326hhh/HLJU_RMIC_chassis/docs/README.md

# 底盘工程文档（底盘库 + 通信链路 + IMU + 上位机对接）

> 本文由原 `docs/CHASSIS_LIBRARY.md`、`docs/CAN_TEST.md`、`docs/CAN_CONTROL_PROTOCOL.md`
> 合并精简而成（2026-11-05），**章节编号沿用原 `CHASSIS_LIBRARY.md` 的 1~19**，
> 因此代码与 `UserLib/*/README.md` 里「见 docs/…§10 / §17 / §6.6」这类引用依旧有效
> （例外：§17 内部合并掉了两节、小节号顺延——原 §17.6 验证现状 → **§17.5**、
> 原 §17.8 一卡一卡 → **§17.7**、原 §17.9 A/B 诊断 → **§17.8**，相关引用已同步改过来）。
> 合并方式是「留结论、删过程」：协议字段表、参数表、标定/实测数据、排障判定表全部保留，
> 长篇排查流水账压成一两行结论。
>
> 分工：**接线**以项目根目录 `README.md` 为准（本文只引用不重复）；
> **各模块用法速查**在 `UserLib/Chassis/README.md` / `UserLib/Comm/README.md` / `UserLib/IMU/README.md`。

- 适用平台：STM32F407VGTx + TB6612 ×2 + 亚博智能 L 型 520 编码器减速电机 ×4（麦克纳姆轮底盘）
- 电机参数：减速比 1:40，磁环 11 线，12 V 供电，减速后空载约 300 RPM（±5%）
- 控制方式：四轮速度闭环（速度前馈 + 参考加速度前馈 + PI）+ 里程计，裸机 1 kHz 周期调度
- 整定状态：2026-10-18 完成四轮速度环实机整定（架空、满占空比），参数见 §7、指标见 §11.3
- IMU：2026-10-19 打通定型（硬件 I2C 400 kHz、SA0 直连 GND、20 分钟 soak 零错误），见 §17
- 上位机：Jetson Nano `~/gimbal`（C++17，控制云台 ZDT X42S ×2）+ 笔记本 `~/gimbal_ctl`，见 §16
- 通信：USART2 串口链路 `uart_link`（§18）与 CAN1 链路 `can_link`（§15），两条链路协议逐字段一致

---

## 目录

| 章 | 内容 |
|---|---|
| [§1](#1-概述) | 概述与设计目标 |
| [§2](#2-参考与借鉴) | 参考与借鉴 |
| [§3](#3-目录结构) | 目录结构 |
| [§4](#4-坐标系与符号约定rm-约定) | 坐标系与符号约定 |
| [§5](#5-架构与数据流) | 架构与数据流（1 kHz 单拍链路） |
| [§6](#6-模块说明) | 模块说明（motor / encoder / pid / mecanum / chassis / debug / demo / tune） |
| [§7](#7-参数配置chassis_configh) | 参数配置与速度环增益 |
| [§8](#8-硬件绑定表chassisc-中-s_bind) | 硬件绑定表 |
| [§9](#9-集成方式) | 集成方式（main.c / NVIC / 编译开关） |
| [§10](#10-上电校准务必按顺序做) | 上电校准（CPR / 方向 / 运动学符号 / 死区） |
| [§11](#11-pid-整定) | PID 整定 |
| [§12](#12-演示程序说明) | 演示程序 |
| [§13](#13-已知限制与后续计划) | 已知限制与后续计划 |
| [§14](#14-附录-a运动学公式推导) | 附录 A：运动学公式推导 |
| [§15](#15-can-通信can_test-验证--can_link-正式协议) | **CAN 通信**：位时序 / `can_test` 验证 / `can_link` 正式协议 / 联调实测 / 排障复盘 |
| [§16](#16-上位机工程jetson-gimbal) | 上位机工程 Jetson `~/gimbal` 与对接点 |
| [§17](#17-imulsm6dsv16x与陀螺偏航闭环小陀螺) | IMU（LSM6DSV16X）与陀螺偏航闭环（小陀螺） |
| [§18](#18-usart2-上位机控制链路userlibcommuart_link) | USART2 控制链路 `uart_link` |
| [§19](#19-版本记录) | 版本记录 |

---

## 1. 概述

本库把底盘控制拆成「测量 / 控制 / 运动学」三层，目标是与 RM（RoboMaster）开源工程同等的工程化水平：

- **测量层**：TIM 编码器模式采样（输入带数字滤波），16 位计数器溢出拼接为 32 位累计，滑动窗口测速；
- **控制层**：车体速度指令 → 麦克纳姆逆解 → 每轮斜坡限幅 → 速度环（速度前馈 + 参考加速度前馈 + PI）→ TB6612 占空比；
- **运动学层**：逆解（指令分配）与正解（里程计）互为逆运算，符号统一。

## 2. 参考与借鉴

结构设计参考了 RM 开源底盘代码的成熟模式（measure/control 分离、轮速斜坡、速度环 PID、运动学独立模块）：

- RoboMaster 开发板 C 型示例工程：<https://github.com/RoboMaster/Development-Board-C-Example>
- rm-controls 框架：<https://github.com/rm-controls/rm_control>

本库为独立实现：不依赖 RTOS、不依赖裁判系统，坐标符号与 RM 约定保持一致，便于后续对接 RM 生态代码。

## 3. 目录结构

```
UserLib/Chassis/
├── chassis_config.h    # 全部可调参数（物理参数/限幅/PID/方向），唯一需要常改的文件
├── chassis_math.h      # 限幅、角度归一、斜坡等内联工具
├── motor.h/.c          # TB6612 单路电机抽象（占空比 ±1000）
├── encoder.h/.c        # 编码器抽象（输入滤波 + 累计计数 + 窗口测速）
├── pid.h/.c            # 位置式 PI(D)：速度前馈、条件积分抗饱和、微分低通
├── mecanum.h/.c        # 麦克纳姆运动学正解/逆解
├── chassis.h/.c        # 主模块：硬件绑定、1 kHz 控制循环、里程计
├── chassis_gyro.h/.c   # 陀螺偏航闭环：小陀螺自旋 / 云台跟随（见 §17）
├── chassis_demo.h/.c   # 演示状态机（可整文件删除）
├── chassis_debug.h/.c  # USART1 调试打印（可用 CHASSIS_DEBUG_ENABLE 关闭）
└── chassis_tune.h/.c   # PID 整定实验模块（默认关闭，见 §6.8）
UserLib/Comm/
├── README.md           # 通信层速查（uart_link / can_link / can_test）
├── uart_link.h/.c      # USART2 串口链路（§18），并对外提供 4 个复用入口供 CAN 调用
├── uart_link_codec.h   # 12 B / 40 B 帧编解码纯函数（PC 侧可编译）
├── uart_link_config.h  # 串口链路全部常量（帧长/命令字/status 位/超时）
├── can_link.h/.c       # CAN1 正式链路（§15.9），协议零重写，只做搬运
├── can_link_config.h   # CAN 帧 ID、位时序、队列深度、错误阈值、CAN_LINK_ENABLE
├── can_test.h/.c       # CAN 链路验证/排障工具（§15.3~§15.6）
└── can_test_config.h   # can_test 全部可调参数 + CANTEST_ENABLE
UserLib/IMU/
├── README.md           # 驱动本身怎么用（接口速查/配置表/上电时序/坑）
├── imu_config.h        # IMU 配置表（I2C 地址/量程/采样率/轴映射）
├── imu.h/.c            # LSM6DSV16X 驱动：I2C 层 + 零偏标定 + 采样 + yaw 积分
├── lsm6dsv16x_reg.h/.c # ST 官方驱动（原样拷贝，不要手改）
tools/
├── step_analysis.py    # 整定数据解析：SET/STEP 二进制块 → 指标 + 曲线
├── spin_analysis.py    # 陀螺自旋实验（实验 5）解析：稳态误差/纹波/超调/漂移
├── uart_link_test.py    # 协议测试向量 + 独立 Python 交叉校验
└── codec_test.c        # PC 上用 gcc 编译 uart_link_codec.h 做编解码自检
test_data/
├── tune_runs/          # 2026-10-18 整定实测原始抓取（.log）与中间结果
└── spin_runs/          # 陀螺噪声/手转/自旋实验的原始串口抓取
docs/
└── README.md           # 本文（原 CHASSIS_LIBRARY.md / CAN_TEST.md / CAN_CONTROL_PROTOCOL.md 已合并至此）
```

## 4. 坐标系与符号约定（RM 约定）

```
            +x（车体前进方向）
             ^
             |
      FL(0)  |  FR(1)         轮子编号顺序：
             |                 0 = FL 左前, 1 = FR 右前
   +y <------+------->         2 = BL 左后, 3 = BR 右后
  （车体左侧）
             |
      BL(2)  |  BR(3)
```

| 量 | 约定 |
|---|---|
| `vx` | +x = 车体前进（m/s） |
| `vy` | +y = 车体左移（m/s） |
| `wz` | 俯视**逆时针**为正（rad/s） |
| 轮速 | 正 = 该轮沿 +x 向前滚动（RPM） |
| 里程计 yaw | 与 wz 同符号，逆时针为正，初始为 0 |

> 这条约定同时是 **USART2 链路（§18.2）**、**CAN 链路（§15.7）** 与 **上位机 `ChassisCommand`（§16.7）**
> 的坐标口径，三条链路已统一，上位机发帧前不需要任何轴交换或取反。
> 旧草案里「`vx` 右 / `vy` 前」的说法已废弃。

## 5. 架构与数据流

```
chassis_set_velocity(vx, vy, wz)
        │
        ▼
┌──────────────────────┐   ┌──────────────────────┐
│  mecanum_inverse()   │   │   encoder_update()   │
│  车体速度 → 四轮RPM  │   │  16bit→32bit + 窗口测速 │
└──────────┬───────────┘   └──────────┬───────────┘
           │ 轮速限幅 ±250RPM         │ 方向归一(ENC_DIR)
           │ 斜坡 ±1500RPM/s          ▼
           ▼                   wheel_rpm_meas[4]
      wheel_rpm_ref[4]                │
           │                          │
           ▼                          ▼
      pid_calc()            mecanum_forward()
      duty = Kff·ref        实测轮速 → vx/vy/wz
           + Kacc·dref/dt          │
           + Kp·e + Ki·∫e           ▼
           （条件积分抗饱和）    里程计积分 (x, y, yaw)
           │
           ▼
      motor_set_duty()
      （±1000 → TB6612 IN1/IN2 + PWM CCR）
```

整条链以 1 kHz 执行一次：`chassis_poll()` 内部检测 `HAL_GetTick()` 的 1 ms 节拍，到点跑一拍。
**主循环里不能再用 `HAL_Delay()` 长时间阻塞**，否则控制会掉拍（掉拍的后果见 §17.8、§18.9 两篇复盘）。

> 整定期间（`CHASSIS_TUNE_ENABLE=1`）控制循环末尾会多回调一次 `chassis_tune_on_tick()`，
> 采样与本拍严格同频；实验本身只改 `s_ref_override[]` / `s_open_duty`，不改控制律。

---

## 6. 模块说明

### 6.1 motor — TB6612 电机抽象

- `motor_init()`：绑定定时器/通道与 IN1/IN2 引脚，启动 PWM 并清零输出；
- `motor_set_duty(motor, duty)`：`duty ∈ [-1000, +1000]`（千分比）。
  - `duty > 0`：IN 电平 = `fwd_in1/fwd_in2`；`duty < 0`：两电平互换；
  - `duty == 0`：IN1=IN2=0（**滑行停止**，非刹车）。

### 6.2 encoder — 编码器

- `encoder_start()`：TIM 编码器模式启动（x4 计数，1760 counts/轮圈），随后**强制写入输入数字滤波**；
- `encoder_update()`：每控制周期采样一次。增量 = 无符号差值截断为 int16，天然处理 16 位回绕
  （前提：单周期增量 < 32767，1 kHz 下余量极大）；累计到 32 位 `total` 并送入滑动窗口；
- `encoder_speed_rpm()`：窗口内增量求和 → RPM。窗口默认 10 ms，低转速分辨率约 3.4 RPM（60/1760/0.01）；
  窗口越大越平滑、延迟越大（`CHASSIS_SPEED_WINDOW_MS`）。

**输入数字滤波（必开）**：`encoder.c` 里 `ENC_INPUT_FILTER = 8`，`encoder_apply_filter()` 在启动后直接改
`CCMR1` 的 `IC1F/IC2F`（bits 7:4 / 15:12）——采样率 `f_DTS/256`、需连续多个一致才认边沿，抑制十几微秒尖峰。

- CubeMX 生成的 `tim.c` 里 `IC1Filter/IC2Filter` 默认 **0（完全不滤）**，电机 PWM 与换相噪声灌进 A/B 线会产生
  **幽灵计数**：2026-10-18 实测 FR 一路在 8000 个 1 ms 采样里出现 **146 次 >20 RPM/ms 的物理不可能跳变**
  （典型：占空比 −598‰ 时瞬间 +65 RPM），把速度环带偏、表现为「反向超调」；
- 改成 8 之后同条件跳变数 **归零**；最高转速下边沿间隔约 122 µs，远慢于滤波窗口，不影响精度；
- 写在 `encoder.c` 而不是 `tim.c`：**CubeMX 重新生成不会覆盖**（用图形界面改也行，两边不冲突）。

### 6.3 pid — 位置式 PI(D)（前馈 + 抗饱和）

每个 1 ms 控制周期：

```
ff   = Kff · ref                      速度前馈：维持该转速需要的占空比
dref = (ref - ref_prev) / dt          目标轮速的导数
I   += e · dt     （条件积分）         e = ref - meas
d    = LPF( d(meas)/dt , τ_d )        一阶低通后的测量微分
out  = Kff·ref + Kacc·dref + Kp·e + Ki·I − Kd·d
out  = clamp(out, ±OUT_MAX)
```

- **速度前馈 `Kff`**：承担「给多少力」，闭环只补偿负载、电压与个体差异。来自 §11 的开环静态标定表
  （`Kff ≈ 稳态占空比 / 稳态转速`，本车 3.50~3.95 ‰/RPM）；
- **参考加速度前馈 `Kacc`**：只在斜坡段非零。斜坡加速时电机本就吃满力矩，若让积分「抢」这段力矩，
  斜坡结束后积分已积了一大坨、必须靠超调慢慢吐。实测加入后：斜坡末端超调 17% → 5~8%，
  500 ms 稳态误差 +4.9 → +0.6 RPM；本车 `Kacc = 0.25 ‰/(RPM/s)`（斜坡 1500 RPM/s 时约等于额外 375‰）；
- **条件积分抗饱和**：输出已顶限幅且误差还在同方向推时，本拍不吸收积分（避免退饱和时要「慢慢吐」）；
- **微分**作用在测量值上并做一阶低通（`CHASSIS_PID_D_LPF_TAU_S`）。**本车 Kd 默认 0**：1 ms 采样 +
  10 ms 窗口的测速量化噪声约 ±2 RPM，Kd=0.08 会放大成数百‰ 的占空比尖刺，速度环基本不需要 D；
- 输出单位是占空比千分比；`i_max` 语义是**积分项**限幅（RPM·s），不是占空比。

### 6.4 mecanum — 运动学

逆解（公式推导见 §14）：

```
omega_i = ( vx + S·ky_i·vy + S·kw_i·wz·(lx+ly) ) / r
ky = {-1,+1,+1,-1}   kw = {-1,+1,-1,+1}   （FL FR BL BR）
S = CHASSIS_ROLLER_SIGN
```

正解为逆解反推，两者共享同一套符号系数，里程计与指令不会互相矛盾。

> ⚠️ **`ky` 与 `kw` 必须同源（2026-11 连续踩了两次）**：两行符号都来自同一套辊筒方向 σ（见 §14），
> `ky = σ`、`kw_i = (x_i·σ_i − y_i)/(lx+ly)`。**单独翻其中一行去「修方向」，就会得到一张几何上不自洽的假表**：
> 1. `kw` 写成 `{-1,-1,+1,+1}`（前后交替）→ 绕 z 净力矩为 0，纯 wz 指令变成「往前窜 + 画弧」，见 §10.3.1；
> 2. `ky` 写成 σ 的负号形式 `{+1,-1,-1,+1}` → `A/D` 平移方向相反，见 §10.3.2。
>
> 两条形状规则：`+wz`（逆时针）→ **左侧两轮往后、右侧两轮往前**；`+vy`（左移）→ 同样的「左侧后、右侧前」
> （同侧同向、异侧反向，两行都是「左右交替」）。幅度取满额 `lx+ly`（标准安装）；镜像安装会退化成
> `lx−ly`，那种情况整表交给 `S` 统一翻。

### 6.5 chassis — 主模块

- 硬件绑定表 `s_bind[]`（见 §8），`fwd_in1/fwd_in2` 是该轮电机转向的**唯一**来源；
- `chassis_set_velocity()`：写入并限幅车体速度指令；
- `chassis_poll()`：1 kHz 控制循环（测量 → 逆解 → 斜坡 → PID → 输出 → 正解 → 里程计）；
- `chassis_state()`：只读状态（实测轮速、占空比、编码器累计、位姿、IMU 量），调试/上位机可读；
- 方向归一系数 `s_enc_dir[]` **只作用于测量值**（修编码器符号），电机转向只由 `s_bind[]` 的 fwd 电平决定。

另有一组**调试/整定专用**入口（正式跑车保持 `CHASSIS_MODE_NORMAL` 即可，对功能无影响）：

| 接口 | 作用 |
|---|---|
| `chassis_set_mode(mode)` | `NORMAL` 正常；`OPEN_DUTY` 四轮直接给同一占空比（绕过 PID）；`WHEEL_REF` 四轮直接给轮速目标（无斜坡）。切模式会清 PID 积分 |
| `chassis_set_open_duty(d)` | 模式 `OPEN_DUTY` 下的占空比，立即生效 |
| `chassis_set_wheel_ref(rpm[4])` | 模式 `WHEEL_REF` 下的四轮目标（RPM），不做斜坡 |
| `chassis_set_wheel_gain(i, kp, ki, kacc)` | 在线改某一轮增益（清积分），整定扫参用 |
| `chassis_driver_enable(0/1)` | 0 = 两块 TB6612 的 STBY 拉低、输出高阻、电机自由（手转测编码器/惯性滑行用） |

### 6.6 chassis_debug — 调试输出（RawData / JustFloat 双协议）

`CHASSIS_DEBUG_ENABLE=1` 时经 USART1（PA9/PA10，115200-8-N-1）每 250 ms 输出一帧，
协议由 `CHASSIS_DEBUG_PROTOCOL` 选择。**发送走 `HAL_UART_Transmit_IT` + 缓冲 + 忙标志**（非阻塞，发不完丢帧），
否则每 250 ms 会阻塞约 17 ms，直接拖垮 1 kHz 控制环（§17.8）。

**RawData 文本**（`CHASSIS_DEBUG_PROTO_RAWTEXT`）：

```
t=12345 | rpm FL  119 FR  119 BL  119 BR  119 | cnt 1760 3520 1760 3520 | yaw=12deg
```

`t` 上电毫秒数；`rpm` 是四轮**实测轮速（已方向归一）**；`cnt` 是四轮**编码器累计计数**（原始方向，手转轮子可直接看）；
`yaw` 里程计偏航角。整行约 110 字节，115200 下约 9.5 ms——`chassis_debug.c` 超时给到 50 ms，改小会截断成半行。

**JustFloat 二进制**（`CHASSIS_DEBUG_PROTO_JUSTFLOAT`，VOFA+ 画波形）：
17 通道小端 float32 + 帧尾 `00 00 80 7F`。二进制模式下终端看不到内容，属正常。

| 通道 | 含义 | 通道 | 含义 |
|---|---|---|---|
| ch0~3 | 目标轮速 ref：FL FR BL BR (RPM) | ch8~11 | 输出占空比 duty：FL FR BL BR (‰) |
| ch4~7 | 实测轮速 meas：FL FR BL BR (RPM) | ch12 | 里程计 yaw (deg) |
| ch13 | 陀螺实测 wz (rad/s) | ch15 | 实际下发 wz_eff (rad/s) |
| ch14 | 陀螺积分 yaw (deg) | ch16 | IMU 在线 (0/1) |

VOFA+ 用法：数据引擎选 **JustFloat**（1.4.5 已内置），拖入 JustFloat 控件，勾 `ch0`（FL 目标）vs `ch4`（FL 实测）
这类对比即可整定。

### 6.7 chassis_demo — 演示

上电 1.5 s 后自动循环：前进 → 左移 → 原地逆时针 90°（里程计闭环）→ 后退 → 右移 → 原地顺时针 90° →
**小陀螺自旋 3 s（陀螺闭环）** → 静止 3 s → 重复。由 `CHASSIS_DEMO_ENABLE`（默认 **0**）控制。

2026-10-18 用本演示做整机验证（四轮架空的满占空比整定版）：前进段四轮 118.5~120.2 RPM（目标 119.4）、
整段 yaw 只漂 0.1°；平移段四轮精确到 ±95.5 RPM。

### 6.8 chassis_tune — PID 整定实验模块

由 `CHASSIS_TUNE_ENABLE`（默认 **0**）整体开关；为 0 时**不参与编译**，对底盘零影响。
打开后 `main.c` 不再调 `chassis_debug_poll()`，改调 `chassis_tune_poll()`。

| 开关 | 说明 |
|---|---|
| `CHASSIS_TUNE_ENABLE` | 1 = 整定模式，0 = 正常模式（默认） |
| `CHASSIS_TUNE_EXPERIMENT` | 1 静态标定 / 2 斜升扫参 / 3 转向目检 / 4 惯性滑行自证 / 5 陀螺自旋实测 |
| `CHASSIS_TUNE_STEP_RPM` | 实验 2 的目标转速幅值（默认 120） |
| `CHASSIS_DRIVER_DISABLE` | 1 = STBY 拉低、电机自由（手转测编码器用），正常必须 0 |

五个实验（上电静置 1 s 后自动开始，数据全部从 USART1 出）：

| 实验 | 内容 | 输出 |
|---|---|---|
| 1 静态标定 | 四轮同占空比按 50→1000‰ 逐档上升、再逐档负向，每档 400 ms，取最后 100 ms 均值 | 文本 `MAP,duty,rpm10_FL,FR,BL,BR` |
| 2 斜升扫参 | 按实际跑车斜坡（1500 RPM/s）做 0→+A→0→−A→0 跟踪；`s_gain_sets[]` 一次排多组 Kp/Ki/Kacc 连续跑完 | 二进制 `SET …` + `STEP_BEGIN n=2000 ch=12` + 2000×24 B |
| 3 转向目检 | +300‰ / −300‰ 循环播放（每轮 5 s），人眼确认四轮同向 | 文本标记 `DIR +300 开始` |
| 4 滑行自证 | 驱动 500‰ 转 1.5 s → 然后 PWM 与 STBY 全断，看编码器是否随惯性平滑衰减 | 二进制同实验 2 |
| 5 陀螺自旋 | 静置 → +自旋速率 → 停 → −自旋速率，各 2 s（走正常模式，陀螺外环真参与） | 二进制 `STEP_BEGIN n=2000 ch=8` + 2000×16 B |

数据块格式（实验 2/4，小端 int16 × 12 通道 × n 样本）：

```
SET idx=0 kp=300 ki=4000 kacc=250 rpm=120     ← 本组参数（kp/ki/kacc 为 ×100/×1000 的定点整数）
STEP_BEGIN n=2000 ch=12 dt_us=1000
<n × 24 字节>                                  ← ch0~3=目标RPM ch4~7=实测RPM ch8~11=占空比‰
STEP_END cksum=<字节累加校验>
```

编排说明（都踩过）：

- 采样在 `chassis_update()` 末尾回调，**与本拍严格同频**，无采样抖动；
- 大块回传必须分片（`HAL_UART_Transmit` 的 Size 是 `uint16_t`，72000 字节会被截断成 6464）；
- 实验跑完立刻回传，回传期间主循环阻塞、控制停摆，但此时占空比已保持 0、电机静止，安全；
- 分析脚本 `tools/step_analysis.py <log>`：解析每个 SET 块的稳态误差/超调/上升时间/噪声/占空比，支持多组参数并排比较。

## 7. 参数配置（`chassis_config.h`）

| 宏 | 当前值 | 说明 |
|---|---|---|
| `CHASSIS_WHEEL_RADIUS_M` | 0.040 | 轮径 80 mm 实测 |
| `CHASSIS_HALF_WHEELBASE_M` | 0.1001 | 轴距 200.20 mm / 2 |
| `CHASSIS_HALF_TRACK_M` | 0.120 | 轮距 240.00 mm / 2 |
| `CHASSIS_ENCODER_CPR` | 1760 | 11 线 × 4 倍频 × 40 减速比（可用 §10.1 手转法校正） |
| `CHASSIS_MAX_WHEEL_RPM` | **250** | 实测满占空比只有 260~296 RPM，指令 280 会顶限幅、闭环没余量。250 ≈ 1.05 m/s |
| `CHASSIS_WHEEL_ACCEL_RPM_S` | 1500 | 轮速斜坡限幅（≈6.3 m/s²，架空够用，落地按抓地力再收） |
| `CHASSIS_MAX_VX_M_S` / `_VY_` | 1.0 | 车体线速度限幅。1.0 m/s = 238 RPM 已贴近上限，**建议实战压到 0.8~0.9** |
| `CHASSIS_MAX_WZ_RAD_S` | 4.0 | 车体角速度限幅 |
| `CHASSIS_ROLLER_SIGN` | +1 | 辊筒朝向（见 §10.3） |
| `CHASSIS_CONTROL_PERIOD_S` | 0.001 | 控制周期 1 kHz |
| `CHASSIS_SPEED_WINDOW_MS` | 10 | 测速滑动窗口（分辨率 ≈3.4 RPM） |
| `CHASSIS_PID_OUT_MAX` | 1000 | 输出限幅（占空比满幅，四轮共用） |
| `CHASSIS_PID_D_LPF_TAU_S` | 0.005 | 测量微分一阶低通，仅 Kd>0 时起作用 |
| `CHASSIS_ENC_DIR_FL/FR/BL/BR` | **+1 / −1 / +1 / −1** | 每轮编码器测量方向归一，2026-10-18 实测标定（见 §10.2） |
| `CHASSIS_DEBUG_ENABLE` | 1 | USART1 调试输出总开关，正式使用改 0 |
| `CHASSIS_DEBUG_PROTOCOL` | JustFloat | 调试协议：RawData 文本 / JustFloat 二进制（VOFA+ 数据引擎要对应） |
| `CHASSIS_DEMO_ENABLE` | 0 | 架空自检时置 1，上电自动跑 §12 的演示 |
| `CHASSIS_TUNE_ENABLE` / `_EXPERIMENT` | 0 / 2 | 整定实验开关与实验号（见 §6.8） |
| `CHASSIS_DRIVER_DISABLE` | 0 | 1 = STBY 拉低、电机自由，仅手转测编码器时用，正常必须 0 |
| `CHASSIS_GYRO_ENABLE` | 1 | 陀螺外环总开关（曾被定义却无人引用，2026-11 修好，见 §17.8） |
| `CHASSIS_SPIN_RATE_RAD_S` | 2.0 | 小陀螺自旋速率（落地实测抓地上限 2.0~2.5，见 §17.5） |

**速度环增益（2026-10-18 整定，实测见 §11.3）**

控制律 `duty = Kff·ref + Kacc·dref/dt + Kp·e + Ki·∫e − Kd·d(meas)/dt`

| 轮 | Kp | Ki | Kd | I_MAX | Kff (‰/RPM) | Kacc (‰/(RPM/s)) |
|---|---|---|---|---|---|---|
| FL 左前 | 3.0 | 40.0 | 0 | 20.0 | 3.85 | 0.25 |
| FR 右前 | 3.0 | 40.0 | 0 | 20.0 | 3.85 | 0.25 |
| BL 左后 | 3.0 | 40.0 | 0 | 20.0 | 3.95 | 0.25 |
| BR 右后 | 3.0 | 40.0 | 0 | 20.0 | 3.50 | 0.25 |

Kff 逐轮不同是**真实的机械差异**（BR 阻力最小：滑行衰减最慢、同样转速所需占空比最低），不是标定误差，
不要图省事改成同一个数。

## 8. 硬件绑定表（`chassis.c` 中 `s_bind[]`）

| 轮 | PWM | 方向引脚 | 编码器 |
|---|---|---|---|
| FL 左前 | TIM5_CH2 (PA1, LF_PWMA) | L_AIN1(PC4) / L_AIN2(PC5) | TIM3 (PA6/PA7) |
| FR 右前 | TIM5_CH4 (PA3, RF_PWMA) | R_AIN1(PE8) / R_AIN2(PE10) | TIM1 (PE9/PE11) |
| BL 左后 | TIM5_CH3 (PA2, LB_PWMB) | L_BIN1(PB0) / L_BIN2(PB1) | TIM4 (PD12/PD13) |
| BR 右后 | TIM9_CH1 (PE5, RB_PWMB) | R_BIN1(PE12) / R_BIN2(PE13) | TIM8 (PC6/PC7) |

其余：`L_STBY=PA4`、`R_STBY=PE7`；调试串口 USART1(PA9/PA10)；编码器全部 `TIM_ENCODERMODE_TI12`
（4 倍频，CPR=1760 不变）。**PWM 频率：TIM5 ≈ 11.7 kHz、TIM9 = 10 kHz**
（TIM5 挂 APB1=42 MHz→定时器时钟 84 MHz，84/72/100；TIM9 挂 APB2=84 MHz→168 MHz，168/168/100）。

`fwd_in1/fwd_in2` 是该轮「正转」时 TB6612 的 IN1/IN2 电平。**新线束沿用旧标定惯例（左轮 (0,1)、右轮 (1,0)）
作为默认值，首次上电必须按 §10.2 重新标定**——某轮实际转向反了，把该轮两个电平对调即可。

## 9. 集成方式

- `CMakeLists.txt`：库源文件已加入 `target_sources`，头文件路径已加入 `target_include_directories`；
- `main.c` 只在 USER CODE 区内动几处：

```c
chassis_init();                     /* 底盘 + IMU（imu_init 在里面，约 1.8 s） */
uart_link_init();                   /* USART2 上位机链路（依赖 NVIC 勾选 USART2 中断） */
#if CAN_LINK_ENABLE
  can_link_init();                  /* CAN 正式链路（§15.9），必须在 MX_CAN1_Init() 之后 */
#endif
#if CANTEST_ENABLE
  can_test_init();                  /* CAN 链路验证工具（§15.3），与 can_link 编译期互斥 */
#endif
#if CHASSIS_TUNE_ENABLE
    chassis_tune_init();            /* 整定模式 */
#elif CHASSIS_DEMO_ENABLE
    chassis_demo_init();            /* 架空自检 */
#endif
...
while (1) {
    chassis_poll();                 /* 1 kHz 控制循环（内部调 imu_poll） */
    uart_link_poll();               /* 收命令 + 看门狗 + 100 Hz 反馈帧 */
#if CAN_LINK_ENABLE
    can_link_poll();                /* CAN：收命令 + 看门狗 + 100 Hz 反馈 + TX pump */
#endif
#if CANTEST_ENABLE
    can_test_poll();                /* can_test：心跳 + 回显 */
#endif
#if CHASSIS_TUNE_ENABLE
    chassis_tune_poll();
#else
    chassis_debug_poll();           /* 非阻塞：HAL_UART_Transmit_IT */
  #if CHASSIS_DEMO_ENABLE
    chassis_demo_poll();
  #endif
#endif
}
```

- **控制环调度**用 `HAL_GetTick()`（SysTick 1 kHz），不占中断；**通信**占三个中断：
  `USART2_IRQHandler`（上位机链路逐字节收帧）、`USART1_IRQHandler`（调试帧非阻塞发送）、
  `CAN1_RX0_IRQHandler`（CAN 收帧）。CubeMX 里 **USART2 / USART1 global interrupt 必须勾选**，
  否则收不到命令 / 发不出调试帧（见 §18.8 坑 1、§17.8）；`.ioc` 已补 `NVIC.USART1_IRQn` 与 `NVIC.USART2_IRQn`。
- 全部集成点在 USER CODE 区内，CubeMX 重新生成不会破坏。

> **CAN 相关调用全部由编译开关控制**（不再注释代码）：`can_link_config.h` 的 `CAN_LINK_ENABLE`
> （正式链路，联调期 1）与 `can_test_config.h` 的 `CANTEST_ENABLE`（链路验证，排障期 1）**编译期互斥**
> （同时为 1 会被 `can_link.c` 顶部 `#error` 拦下）；两者都关 = 整定期，CAN 完全不参与，
> 不会污染 USART1 调参数据。详见 §15。

## 10. 上电校准（务必按顺序做）

> 2026-10-18 已按本节完整跑过一遍，结论见 §10.5。**重新布线/换线后必须重做 §10.2。**

### 10.1 编码器 CPR 实测

1. 驱动板不使能（`CHASSIS_DRIVER_DISABLE=1`，或断开电机电源），把某轮**手转整一圈**；
2. 看 §6.6 RawData 的 `cnt` 字段，或读 `chassis_state()->wheel_count[轮]` 的变化量；
3. 应为 1760 左右，把实测值写回 `CHASSIS_ENCODER_CPR`。

> 手转可靠：用 §6.8 实验 4（惯性滑行）验证过——断开 STBY 与 PWM 后实测转速从 133 RPM 平滑衰减到 0
> （τ≈0.35 s），而不是瞬间归零。

### 10.2 每轮方向标定（电机方向 与 编码器方向 分开修）

1. **先跑 §6.8 实验 1（开环静态标定）**：看 `duty = +1000` 那一行，**读数符号与占空比同号**的轮子不用动；
   **反号**的把对应 `CHASSIS_ENC_DIR_x` 取反。这一步全自动，不用人眼；
2. **再跑 §6.8 实验 3（转向目检）**：+300‰ / −300‰ 循环播放，人眼确认四轮物理转向一致（正占空比都朝车头滚）。
   某轮反了 → 去 `chassis.c` 的 `s_bind[]` 对调该轮 `fwd_in1/fwd_in2`，**同时**把该轮 `ENC_DIR` 再取反一次
   （保持「测量符号 = 占空比符号」这个不变量）；
3. 正常状态：前进段四轮转速接近、占空比不饱和、yaw 基本不变。

> 为什么必须分开修：电机方向（TB6612 接线）与编码器方向（A/B 线）是两套独立线缆，可能只反一个。
> 只反电机线而编码器没反，闭环会把该轮推到全速——就是「一侧明显更快」的来源。
> **编码器反号的典型症状：实测为负 + 该轮占空比顶在 ±1000 飞转。**

### 10.3 运动学符号（`CHASSIS_ROLLER_SIGN`）

用 §12 的演示（`CHASSIS_DEMO_ENABLE=1`）分别验证前进 / 左移 / 旋转三段：

- 前进跑偏（车身斜着走）→ 回 §10.2 查方向；
- **左移变成右移** → 只反 `K_VY` + 正解 `vy` 行（两处一起），**不要**动 `CHASSIS_ROLLER_SIGN`（见 §10.3.2）；
- **只有旋转方向反、平移正常** → 同理，只反 `K_WZ` + 正解 `wz` 行（见 §10.3.1）；
- ⚠️ `S` 是「整机辊筒镜像」的总开关，作用面是 vy + wz **两项**：只要前进/平移/旋转里有一项是对的，
  就说明不是镜像装，别再翻它。**单轴方向反 ≠ 镜像装**；
- ⚠️ 也别「哪行反了翻哪行」翻到顺手：`ky` 与 `kw` **同源**。正确顺序是**先用 A/D 定出 σ 的符号**，
  再让 `ky = σ`、`kw = (x_i·σ_i − y_i)/L` 一起写。

#### 10.3.1 复盘：纯 wz 指令 →「先向前走、再转弯」（2026-11）

**现象**：按住 Q/E（只给 wz，`vx = vy = 0`）时，车不是原地转，而是先往前窜、再画弧。

**根因**：`mecanum.c` 的 `K_WZ` 写成 `{-1,-1,+1,+1}`（前后两对反着转）。按 §14，wz 项系数
`(x_i·σ_i − y_i)` 只有在 σ 左右交替时才让 x 项与 y 项同向叠加、四轮幅度都等于 `lx+ly`；
写成前后交替则两项相消、净力矩为 0。同一份错也在 `mecanum_forward()` 的 wz 行，**两处必须一起改**
（否则里程计 yaw 与真实转向相反）。

**为什么一直没暴露**：架空实验只能证明逆解算得对、证明不了能转；手转外环只看四轮符号；
曾把落地 +3.5 rad/s 只跑到 1.97 rad/s、FL 顶在 −1000‰ 而 BR 跑到 240 RPM 的内战痕迹，
当成「地砖打滑 ≈30%，属物理极限」放过了。

**修法**：

```c
static const float K_WZ[4] = { -1.0f, +1.0f, -1.0f, +1.0f };          // 原 {-1,-1,+1,+1}
*wz = roller * r * 0.25f / l * ( -w[FL] + w[FR] - w[BL] + w[BR] );    // 原 -FL -FR +BL +BR
```

**验证**：烧录后按 Q 应为 **FL−、FR+、BL−、BR+**，车纯原地逆时针，陀螺 `wz` 为正；按 E 整体取反。
若修后整体反向而 A/D 正常 → 只把 `K_WZ` 与正解 wz 行**整行取反**，仍不动 `S`。

#### 10.3.2 复盘②：A/D 平移方向反（`K_VY` 取了 σ 的负号）

**现象**：W/S 正常，但按 `A`（协议 `+vy` = 左移）车往**右**走。

**根因**：`K_VY` 写成 `{+1,-1,-1,+1}`，而实车辊筒是**标准安装**（σ = {−1,+1,+1,−1}），`ky` 取了 σ 的负号
⇒ 等于把 "+y" 定义在了另一侧。与 §10.3.1 是同一类错误。之所以晚发现：转向 bug 更「显眼」（不转、乱窜），
平移反向被当成「车就这样」放过；而且 `tools/uart_link_test.py` 的 `vy` 期望符号当初是跟错表一起写的，跑起来也「通过」。

**修法**（两处成对改）：

```c
static const float K_VY[4] = { -1.0f, +1.0f, +1.0f, -1.0f };              // 原 {+1,-1,-1,+1}
*vy = roller * r * 0.25f * ( -w[FL] + w[FR] + w[BL] - w[BR] );            // 原 +FL -FR -BL +BR
```

**验证**：按 `A` 车左移（四轮 **FL−、FR+、BL+、BR−**），按 `D` 右移（整体取反）；HUD 的 `vy` 正解与指令同号；
W/S、Q/E 行为不变。

> 教训（两次都是）：**发现某个方向反了，先问「这一行代表哪条轴」，别急着找宏开关。**
> `S` 只负责「整机镜像」这种两项同时反的场合；单轴反一定是那一行表写错了。

### 10.4 死区与最低占空比

TB6612 + 减速电机启动死区实测（2026-10-18，架空）：

- **正向死区约 80~100‰**：+50‰ 四轮都不转，+100‰ 才勉强起步（8~12 RPM）；
- **反向死区更小**，约 50‰ 就有 6 RPM（正反向摩擦不对称）；
- 死区由速度环积分自动补偿，实测指令低到 **25 RPM 仍能稳在 ±1 RPM**（占空比约 100‰，噪声 1.5 RPM），
  不需要额外死区补偿；再往低（<15 RPM）会掉进死区、可能出现走走停停的极限环——**这一段尚未实测**。

### 10.5 2026-10-18 标定结论（重新布线后的首次完整标定）

| 项 | 结论 |
|---|---|
| 编码器方向 | FL **+1** / FR **−1** / BL **+1** / BR **−1**（右两轮 A/B 线接反，只修测量符号） |
| 电机方向（`s_bind[]` fwd 电平） | **(0,1)/(1,0)/(0,1)/(1,0)** 保持不变，人眼确认四轮正向一致 |
| 编码器输入滤波 | 必须开（`ENC_INPUT_FILTER=8`），否则 FR 一路大量幽灵计数（§6.2） |
| 占空比-转速增益 | 满占空比 260~296 RPM，低档斜率约 0.28 RPM/‰，**逐轮差异明显**（BR 最快） |
| 启动死区 | 正向约 80~100‰、反向约 50‰ |
| 机械阻力 | BR 最小（滑行 τ≈0.7 s）、FL 最大（τ≈0.35 s），是 Kff 逐轮不同的物理来源 |

## 11. PID 整定

> 当前参数见 §7 的增益表；本节记录**方法**与 **2026-10-18 实测结论**。
> 四轮参数**相互独立**，先四轮同参整定，再按 Kff 逐轮微调。

### 11.1 控制律与各参数职责

`duty = Kff·ref + Kacc·dref/dt + Kp·e + Ki·∫e − Kd·d(meas)/dt`

| 参数 | 管什么 | 怎么定 |
|---|---|---|
| `Kff` | 承担全部「稳态出力」，闭环只做补偿 | 开环静态标定表直接算：`Kff = 稳态占空比 / 稳态转速` |
| `Kacc` | 斜坡段的加速力矩 | 扫参定：太小则斜坡末端超调大，太大则反向冲过 |
| `Kp` | 带宽/相位裕度 | 有前馈后 Kp 只需纠正残余误差，过大反而制造占空比尖刺 |
| `Ki` | 稳态误差收敛速度 | 决定误差多久被吃掉（本车 ≈0.2~0.3 s），过大在斜坡末段顶出超调 |
| `Kd` | — | **速度环不要用**：测速量化噪声 ±2 RPM，微分会放大成几百‰ 的尖刺 |

### 11.2 整定流程（可复现）

1. **静态标定**（实验 1）：得到逐轮占空比-转速曲线 → 算 `Kff`（取工作点附近，本车 120 RPM 处），
   顺便确认方向（§10.2）与死区；
2. **定 Kacc**（实验 2）：Kp/Ki 固定，`s_gain_sets[]` 扫 `{0, 0.08, 0.16, 0.25}` 一次烧录跑完，
   看「斜坡结束后的超调」与「500 ms 稳态误差」，取两者都小的；
3. **定 Kp/Ki**（实验 2）：固定 Kacc，扫 `Kp×Ki` 组合，目标稳态误差 <1 RPM、超调 <10%；
4. **全速域验证**：目标幅值改成 25 / 60 / 120 / 240 RPM 各跑一轮，确认低速（死区附近）和高速（接近占空比上限）都不发散；
5. 数据用 `tools/step_analysis.py` 解析，多组参数并排比较。

### 11.3 2026-10-18 实测结果（四轮架空、满占空比、稳压供电）

| 目标 | 四轮稳态误差 | 超调 | 测速噪声 (std) |
|---|---|---|---|
| 25 RPM | −1.1 ~ +0.0 | 8% | 1.5 |
| 60 RPM | −0.3 ~ +0.1 | 8~13% | 1.5 |
| 120 RPM | −0.6 ~ +0.9 | 5~11% | 1.7~2.0 |
| 240 RPM | −5.4 ~ +3.2 | 4~8% | 1.5~2.8 |

- 参考轨迹是**实际跑车的斜坡**（1500 RPM/s，0→120 RPM 用 80 ms），不是理想阶跃——理想阶跃会把 Kp 冲击放大到不真实；
- 240 RPM 档的 2% 误差是因为占空比已到 780~940‰，闭环余量变小；
- **280 RPM 达不到**：占空比顶 1000‰ 仍只有 252~297 RPM，属物理极限，所以 `CHASSIS_MAX_WHEEL_RPM` 改成 250。

### 11.4 现象 → 对策

| 现象 | 原因 | 对策 |
|---|---|---|
| 稳态差一截、占空比没饱和 | 前馈偏小 / 积分太慢 | 加大该轮 `KFF`；或加大 `KI` |
| 占空比短时冲到近 1000 再回落 | 缺加速度前馈，积分在坡度里「抢」力矩 | 加大 `KACC`（0.05 一档试） |
| 斜坡结束超调明显、回落慢 | `KI` 偏大或 `KACC` 偏小 | 先加 `KACC`，再考虑降 `KI` |
| 转速随机尖刺、占空比抖 | 编码器幽灵计数（滤波没开/线接触不良） | 先查 §6.2 的 `ENC_INPUT_FILTER`，再查接线 |
| 某轮反向时冲得特别猛 | 正反向摩擦不对称（反向死区更小） | 该轮 `KFF` 略降，让积分慢慢补 |
| 占空比顶 1000 但转速上不去 | 物理极限（负载/供电/堵转） | 调参无用，查供电与机械 |

### 11.5 整定前提

- 用**满电电池或稳压电源**：长时间运行占空比会随电池掉压漂移（同样转速要更大占空比）；
- 架空整定得到的是**无载**参数，落地后负载更大、死区更明显；建议落地后低速（0.2~0.3 m/s）复测 yaw 漂移，
  必要时把 `KFF` 整体上调 5~10% 让积分少干活。

## 12. 演示程序说明

- 由 `CHASSIS_DEMO_ENABLE` 控制（默认 0）；置 1 后上电 1.5 s 开始（留出把车放到地上的时间）；
- 两个旋转段用**里程计 yaw** 闭环，转满 90° 即进入下一段——同时验证运动学正解与编码器方向；
- 若某段行为与预期相反，按 §10 顺序排查，不要改演示逻辑本身。

## 13. 已知限制与后续计划

- **角度仍是「各算各的」**：里程计 yaw 来自轮速积分（打滑会累积），陀螺 yaw 来自 gz 积分（会漂移），
  两者没有融合；陀螺外环只用 wz（速率），不用角度。要长时角度保持（云台跟随），需要
  「不打滑时用里程计校正陀螺 yaw」的互补滤波——取舍见 §17.5；
- **自旋速率受抓地限制**：实测地砖上约 2.0~2.5 rad/s，`CHASSIS_SPIN_RATE_RAD_S` 已按此设为 2.0（§17.5）；
- 未做电流环（TB6612 无电流采样），堵转保护靠限幅 + 后续可加堵转检测；
- 电机制动未用短路刹车（停止为滑行），如需刹车可扩展 `motor_brake()`；
- **落地闭环指标未测**：小陀螺的稳态误差/纹波/超调还缺一次干净的落地实测；
- **满速上限 250 RPM**（≈1.05 m/s）：占空比 1000‰ 只有 260~296 RPM，`CHASSIS_MAX_VX` 给 1.0 已贴近上限；
- **四轮参数不能通用**：Kff 3.50~3.95、机械阻力差异明显，逐轮差异是物理事实；
- **正反向不对称**：反向死区（≈50‰）明显小于正向（≈80~100‰），反向低速时积分补得多一些，属正常；
- **当前参数是架空整定的**：落地后 Kp/Ki 可能偏软、Kff 可能偏小，建议按 §11.5 复测；
- **编码器 A/B 线仍建议复查**：滤波把 FR 的幽灵计数压到 0，但 100+ 次/8000 采样说明该路存在噪声/接触问题，
  滤波是软件兜底而非修好硬件；
- **云台 ZDT 尚未切 CAN 模式**：底盘与云台的 CAN 混跑已在总线上验证（§15.10 第三轮），但云台仍走 UART，
  `--device can0` 全 CAN 端到端待 ZDT 切模式后联调（§16.9）。

## 14. 附录 A：运动学公式推导

设轮 i 位于 (x_i, y_i)（车体坐标系，前 +x、左 +y；四轮 = (±lx, ±ly)），车体速度 (vx, vy, wz)，轮半径 r：

轮毂速度：`u_i = (vx − wz·y_i, vy + wz·x_i)`

辊筒轴 ê_i 与轮平面（x̂）成 45°，记 **σ_i = e_y/e_x ∈ {+1,−1}**（同一根轴的 ± 只是符号约定，物理等价）。
由「接触点沿辊筒轴无滑动」：

```
(u_i − s_i·x̂)·ê_i = 0   =>   s_i = (u_i·ê_i) / (x̂·ê_i)   （s_i = r·omega_i）
```

代入展开：

```
s_i = (vx − wz·y_i) + σ_i·(vy + wz·x_i)
    = vx + σ_i·vy + wz·(x_i·σ_i − y_i)
```

**wz 项的系数就是 `(x_i·σ_i − y_i)`，这是整个推导的关键**：只有当 σ **左右交替**时，`x_i·σ_i` 与 `−y_i`
才同向叠加、四轮幅度都等于 `lx+ly`；若取成前后交替，两项相消，系数只剩 `|lx−ly|`（本车 lx≈ly，几乎为 0），
车体绕 z 轴的驱动力矩为 0——**物理上转不动**，而不是「转得慢」。

标准安装 σ = {−1,+1,+1,−1}（FL FR BL BR）：

| 轮 | omega_i·r |
|---|---|
| FL | vx − vy − wz·(lx+ly) |
| FR | vx + vy + wz·(lx+ly) |
| BL | vx + vy − wz·(lx+ly) |
| BR | vx − vy + wz·(lx+ly) |

即 `ky = {−1,+1,+1,−1}`、`kw = {−1,+1,−1,+1}`——**这就是本库现在用的表**（实车已按 §10.3 验证：
`+vy` 确实左移、`+wz` 确实逆时针）。

历史注记：库里曾把 `ky` 写成它的负号形式（等于把 "+y" 定义在另一侧），实车表现就是 `A/D` 方向相反（§10.3.2）。
另外 σ 整体取反（镜像安装）只会让 `kw` 幅度退化成 `(lx−ly)/(lx+ly)` 倍、`ky` 保持 ±1 —— 那种情况两行要一起翻
（即 `S = −1`），不能只翻一行。

正解为上述线性组合的反推（与逆解共用同一套系数）：

```
vx = r/4·(ωfl + ωfr + ωbl + ωbr)
vy = r/4·(ωfl − ωfr − ωbl + ωbr)
wz = r/(4(lx+ly))·(−ωfl + ωfr − ωbl + ωbr)
```

## 15. CAN 通信（can_test 验证 + can_link 正式协议）

> 两个模块，一套协议：
> - **`can_test`**（§15.3~§15.6）：**链路验证与排障工具**。心跳 / 点灯 / 回显 / silent-loopback 自检 / TEC·REC·LEC 诊断，
>   回答「F407 和 Jetson 到底通不通」。`CANTEST_ENABLE=1` 时启用。
> - **`can_link`**（§15.7~§15.10）：**正式控制链路**，帧表见 §15.7，实现要点见 §15.9。
> - 两者都要初始化 CAN1，**编译期互斥**（同时为 1 被 `#error` 拦下）。
>
> 串口协议（§18）是**唯一权威**，CAN 映射字段语义与它逐字段一致。

### 15.1 为什么 CAN 命令帧要单独"再 Init 一次"

本工程 `.ioc` 早期只有 CubeMX 算出来的 `CAN1.Calculate*` 键，**没有 `Prescaler`/`BS1`/`BS2`/`SJW`
这几个真正生效的键**，从 CubeMX 重新生成时位时序会被默认值覆盖。而默认值（实测生成的 `Core/Src/can.c`）是：

```c
hcan1.Init.Prescaler = 16;
hcan1.Init.TimeSeg1  = CAN_BS1_1TQ;   /* 1 TQ */
hcan1.Init.TimeSeg2  = CAN_BS2_1TQ;   /* 1 TQ */
```

一位只有 **3 个 TQ**、采样点 66.7% —— CAN 需要留出传播段和相位缓冲段来容忍晶振偏差与线延迟，
**这个配置在硬件上不可能稳定通信**（875 kbps × 3TQ）。

所以 `can_test_init()` / `can_link_init()` 都拿 `*_config.h` 里的值**再 `HAL_CAN_Init()` 一次**强制覆盖
（`MX_CAN1_Init()` 已配好时钟与 GPIO，第二次 Init 不会重复调 `MspInit`，只覆盖位时序，安全）。
**真值现已写回 `.ioc`**（`IPParameters` 里含 `BS1,Prescaler,BS2`），判断是否修好就看这一项。

实际速率可以运行时从 `CAN_BTR` 反读（不信配置信寄存器）：`can_test_get_state().bitrate_hz` 应为 `1000000`。

### 15.2 位时序速查

CAN1 挂 APB1。`PLLM=4 / PLLN=168 / PLLP=2` → HCLK 168 MHz，APB1 = /4 = **42 MHz**。
固定 **14 TQ**（`1 + 11 + 2`）时：`位速率 = 42 MHz / 14 / Prescaler = 3 Mbps / Prescaler`，
采样点恒为 85.714%，**换速率只改 Prescaler 一个数**：

| 速率 | Prescaler | 速率 | Prescaler |
|---|---|---|---|
| **1 Mbps** | **3** | 125 kbps | 24 |
| 500 kbps | 6 | 100 kbps | 30 |
| 250 kbps | 12 | 50 kbps | 60 |

采样点 = `(1 + BS1) / (1 + BS1 + BS2)`，CAN 推荐 75%~87.5%。
例外：400 kbps 需 15 TQ（Prescaler 7 / BS1 12 / BS2 2，采样点 86.7%）；800 kbps 在 42 MHz 下**无法精确生成**
（需 `Prescaler × TQ = 52.5`），建议 750 k 或 1 M。**改主频必须重算**，`CANTEST_APB1_HZ` 跟着改。

### 15.3 can_test：能力与帧格式

| 能力 | 说明 |
|---|---|
| ① 心跳 | 每 500 ms 发一帧 `0x7F0`，数据 `[序号, 0xCA, 0xFE, 已收帧数低 8 位]` |
| ② 回显 | 收到任何帧原样回一帧，标准帧 ID + 1；扩展帧统一回 `0x123` |
| ③ 点灯 | 收到 `0x200` 控制帧 → 操作 PB2 板载 LED → 回 `0x201` 应答 |
| ④ 自诊断 | 每 1 s 经 USART1（115200 8N1）打印速率、收发计数、TEC/REC/LEC |
| ⑤ 自检 | silent-loopback 模式自发自收，**不依赖任何适配器**即可验证协议链路 |

| ID | 方向 | 内容 | 数据 |
|---|---|---|---|
| `0x7F0` | F407 → 上位机 | 心跳 | `[seq, 0xCA, 0xFE, rx_count & 0xFF]` |
| `0x200` | 上位机 → F407 | LED 控制 | `[cmd]`：`0`=灭 `1`=亮 `2`=翻转（无数据按翻转） |
| `0x201` | F407 → 上位机 | LED 应答 | `[cmd, 当前状态, rx_count & 0xFF, 0xA5]` |
| 收到的 ID + 1 | F407 → 上位机 | 回显 | 原样转发 |

未知 `cmd` 不改灯但仍回 `0x201`；`0xA5` 是应答帧专属魔数。标准帧（11 位）用于 Jetson ↔ F407，
扩展帧（29 位）留给云台 ZDT，两者天然隔离不冲突。

**Jetson 侧两条验证命令**（都通过 = 通信完全正常）：

```bash
candump can0                                   # ① 心跳：每 0.5 s 一行  can0 7F0 [4] 00 CA FE 00
candump can0 & cansend can0 123#A1B2C3D4       # ② 双向回显：应看到 can0 124 [4] A1 B2 C3 D4
```

心跳里的 `CA FE` 是识别魔数，第 4 字节是 F407 已收帧数低 8 位——光看心跳就知道**对面收没收到东西**。

### 15.4 can_test：配置三档与四个坑

`can_test_config.h` 是全模块唯一需要动的文件：

| 用途 | `LOOPBACK_SELFTEST` | `HEARTBEAT_ENABLE` | `AUTO_RETRANSMIT` | `ECHO_ENABLE` |
|---|---|---|---|---|
| **正常联调**（接真适配器） | `0` | `1` | `1` | `1` |
| **诊断**（对面不响应，看错误计数器） | `0` | `0` | `0` | `0` |
| **自检**（无适配器，验证协议逻辑） | `1` | `0` | `0` | `0` |

⚠️ **自检档必须关回显**：回环下 `0x201` 会被回显成 `0x202`、再 `0x203`……无限套娃把三个发送邮箱塞爆，
`err` 变成 `0x00200000`（`HAL_CAN_ERROR_PARAM` = 邮箱满）。
`CANTEST_LED_ACTIVE_HIGH`：PB2 极性，`1` = 写高电平灯亮，实测本板为 `1`。

| # | 坑 | 现象 | 解法 |
|---|---|---|---|
| 1 | **滤波器不配** | 一帧都收不到（HAL 不会自动给默认滤波器，FIFO 全拒） | 掩码全 0 的全通过滤波器，占第 0 组 |
| 2 | **位时序被 CubeMX 覆盖** | 能编译能下载，但物理上通不了信 | 运行时强制重配（§15.1）+ 把真值写进 `.ioc` |
| 3 | **自己发的帧收不到** | `bus.recv()` 返回 None，但 TX 计数在涨 | SocketCAN 的 `CAN_RAW_RECV_OWN_MSGS` 默认关；python-can 需 `receive_own_messages=True`，或另开 `candump` |
| 4 | **`err=0x00200000`** | `tx` 卡住不涨 | `HAL_CAN_ERROR_PARAM` 在 `AddTxMessage` 里意为**三个邮箱全满** → 对面没 ACK，而 `AutoRetransmission` 让帧无限重传 |

另有两个 F407 平台常识：**CAN1/CAN2 共用滤波器组**（14 组，`SlaveStartFilterBank=14`，用 CAN2 前必须先初始化 CAN1）；
初始化顺序必须是 **`HAL_CAN_ConfigFilter()` → `HAL_CAN_Start()` → `HAL_CAN_ActivateNotification()`**，
反过来 `ConfigFilter` 直接返回 `HAL_ERROR`。本工程默认**主循环轮询** FIFO0（`CANTEST_USE_RX_INTERRUPT=0`），
要改中断需在 CubeMX 勾 `CAN1 RX0 interrupts` 并把该宏设 1，**两者不要同时开**（同一帧会被处理两次）。

### 15.5 can_test：用 TEC / REC / LEC 定位故障层

HAL 的 `ErrorCode` 只反映**软件调用层**，看不到总线层错误计数器。`can_test` 直接从 `CAN_ESR` 反读并打印：

```
CAN 1000000bps | tx=45 rx=44 err=0x00000000 bof=0 | TEC=45 REC=0 LEC=none
```

**这张表把「通不通」拆成可判定的三档**，是整个排障过程最有价值的部分：

| 读数 | 结论 | 下一步 |
|---|---|---|
| `REC = 0` 且 `LEC = none` | **完全听不到总线**（RX 引脚一直隐性） | 查物理层：收发器供电、CAN_H/CAN_L、终端电阻 |
| `REC > 0` 或 `LEC = STUFF/FORM/CRC` | **听到了波形但解不出来** | 位速率 / 采样点不一致 |
| `LEC = ACK` 且 `TEC` 上涨 | 发得出去但**没人应答 ACK** | 对面没上电、线断、或对面收发器没工作 |
| `TEC = 0` + `tx` 不涨 + 总线上量不到电平变化 | **设备侧压根没往外发** | 适配器/驱动问题，与 MCU 无关 |

常见现象对照：`tx` 在涨 = 发送侧正常；`rx` 一直 0 = **收不到，查滤波器和中断**；`bof=1` = **物理层问题**。

**物理层检查（软件查不出来时）**——KCAN 类适配器**不上报 ACK 错误**（`rec/tec` 恒 0/0），
软件侧无法判断"对方在不在总线上"，必须用万用表：

| 测点（断电） | 应该 | 测点（通电，黑笔接 GND） | 空闲时 |
|---|---|---|---|
| CAN_H ↔ CAN_L | **~60 Ω**（两端各 120 Ω 并联） | 收发器 VCC | 5 V 或 3.3 V |
| CAN_H ↔ GND | >1 MΩ | CAN_H / CAN_L | 各 **~2.5 V**（隐性电平） |
| CAN_L ↔ GND | >1 MΩ | MCU PB9 (CAN1_TX) / PB8 (CAN1_RX) | 3.3 V 高 |

> CAN 是差分总线，**物理层不通软件怎么调都是白费**。

### 15.6 can_test：实测结论

**F407 侧全链路已验证合格**（silent-loopback 自检：`tx`/`rx` 每秒同步 +2、`TEC=0 REC=0 LEC=none`）：
滤波器配置 → RX FIFO 轮询 → `can_test_handle_rx()` 分发 → LED 写入 → `0x201` 应答发送，全部正确。

物理层实测（万用表）：

| 测点 | 实测值 | 判定 |
|---|---|---|
| TJA1050 `VCC` (pin 3) | 5 V | ✅ 收发器有电 |
| `CANH` / `CANL`（发帧时） | 3.10 V / 1.704 V | ✅ 差分显性，TJA1050 输出正常 |
| `CANH ↔ CANL`（断电，接上适配器） | 118.9 Ω | ✅ 板子 120 Ω 终端在，导线通 |

原理图核对：`CAN1_RX → PB8`、`CAN1_TX → PB9`、收发器 `TJA1050T`、网络名 `CANH/CANL`，与固件一致，
且与 I2C1（PB6/PB7）无冲突。**当时的唯一卡点是上位机侧 CAN 适配器**，与底盘代码无关（选型见 §15.11）。

### 15.7 正式协议：底盘帧表（`can_link`）

#### 15.7.1 Jetson → F407

**`0x000` 广播急停（DLC=0，最高优先级）**

CAN 仲裁 ID 越小优先级越高，`0x000` 能**插队打断一切流量**。收到后：`chassis_driver_enable(0)`（STBY 拉低）
+ 清速度 + 锁存急停。**这是唯一的「硬急停」通道。**

> **约定（2026-10-19 双方定）：Jetson 发、F407 只收不发。**
> F407 暂不广播的原因见 §15.7.5；等「故障检测」专题落地后再启用，届时新增 **`cmd = 0x05` = 清故障锁存**
> （不能用 0x04——那是清零里程计，语义不同）。

**`0x020` 速度命令（100 Hz）**

| 字节 | 0 | 1 | 2..3 | 4..5 | 6..7 |
|---|---|---|---|---|---|
| 含义 | `cmd` | `seq` | `vx`（i16 LE，mm/s，+前进） | `vy`（i16 LE，mm/s，+左移） | `wz`（i16 LE，0.01 rad/s，+逆时针） |

`cmd`：`0x01` 速度 / `0x02` 应用级急停（与 `0x000` 不冲突，保留）/ `0x03` 小陀螺 / `0x04` 清零。
`seq` 8 bit，100 Hz 下 2.5 s 回绕一次。

**`0x021` 标志帧（10 Hz 保活 + flags 变化时立即发）**

| 字节 | 0 | 1..7 |
|---|---|---|
| 含义 | `flags`（bit0 = EN 允许驱动） | 保留填 0 |

从 100 Hz 降到 10 Hz：flags 是慢变量，100 Hz 纯浪费带宽；变化时立即发保证响应性。

#### 15.7.2 F407 → Jetson 反馈（100 Hz，`0x110` ~ `0x114`）

把串口 40 B 反馈帧（§18.3）**按 8 字节顺序切成 5 帧**：

| CAN ID | 数据段 = 串口帧字节 |
|---|---|
| `0x110` | 0..7 （`5A A5 81` + `seq` 回显 + `x[0..3]`） |
| `0x111` | 8..15（`x[4..7]` + `y[0..3]`） |
| `0x112` | 16..23（`y[4..7]` + `yaw_cdeg` + `vx` + `vy`） |
| `0x113` | 24..31（`wz` + `gyro_yaw` + `gyro_wz` + `status` + `cmd_cnt` + `fb_seq[0]`） |
| `0x114` | 32..39（`fb_seq[1]` + 四轮 RPM×4 + `crc8` + `0x0D`） |

**接收端必须实现组完整性规则**（否则会出现「偶发底盘状态跳变」这种极难查的问题）：

1. 收到 `0x110` → **开新组**，清缓冲；
2. 收到 `0x111~0x114` → 按序填入；
3. 收到下一个 `0x110` 时上组**未拼满** → 丢弃上组；
4. 距 `0x110` 超过 **5 ms** 仍未拼满 → 丢弃（F407 用 TX 队列连续发，组内延迟 ≤2 ms，5 ms 有 2.5 倍余量）；
5. `crc8` 校验失败 → 丢弃整组，**不输出**。

#### 15.7.3 带宽

| 流量 | 帧数/s | 1 Mbps 负载 |
|---|---|---|
| `0x020` @100 Hz | 100 | ≈1.5% |
| `0x021` @10 Hz | 10 | ≈0.15% |
| `0x110~0x114` @100 Hz | 500 | ≈7% |
| 云台 ZDT 命令+遥测 | ~100 | ≈1.5% |
| **合计** | ~710 | **≈10%** |

#### 15.7.4 三条技术风险（双方知悉）

1. **5 帧反馈不是原子的**：ZDT 扩展帧可能插在中间、某帧可能丢失/被打断 → 必须按 §15.7.2 组规则处理
   （`crc8` 兜不住组边界问题）；
2. **F407 只有 3 个发送邮箱**：100 Hz × 5 帧 = 每 10 ms 突发 5 帧，`HAL_CAN_AddTxMessage()` 邮箱满会直接失败
   （实测 `HAL_CAN_ERROR_PARAM`）。**定案：TX 环形队列连续发（组内 ≤2 ms），不用 2 ms 错开**——
   错开会让反馈整体滞后 8 ms，浪费一帧实时性，带宽余量充足；
3. **`0x021` 100 Hz 太浪费**：降到 10 Hz + 变化即发。

#### 15.7.5 为什么 F407 暂不广播 `0x000`

F407 当前没有故障检测框架（只有 IMU_ONLINE 和看门狗两个状态位），三类已有异常都不适合广播急停：

| 异常 | 广播 0x000 有用吗 | 说明 |
|---|---|---|
| 看门狗超时（100 ms 收不到命令） | ❌ | 已经停车了；若是 Jetson 掉线，广播也没人收 |
| bus-off（总线故障） | ❌ | 根本发不出去（最讽刺的一点） |
| IMU 离线 | ❌ | 底盘靠编码器仍能跑，IMU 是辅助，不该急停 |

真正该广播的场景（编码器全失效、欠压、驱动芯片故障）需要先做故障检测，属后续迭代。

### 15.8 status 增加 CAN 错误标志位

| 位 | 值 | 含义 |
|---|---|---|
| 新增 | `CAN_ERR = 0x0100` | F407 进入 CAN error-passive（TEC/REC > 96）时置位，供 Jetson 从数据里看到告警，不用读寄存器 |

`0x0001~0x0080` 已占满低 8 位，`0x0100` 正好是下一个空位，**无冲突**。
读 `CAN_ESR` 的 TEC/REC，**任一 > 96** 即置位（96 是 error-passive 预警线，127 才真正降级）；
**是实时状态位、不是锁存位**，计数降回来自动清零。

错误处理约定：**bus-off** 用 bxCAN 硬件级 **AutoBusOff（ABOM）** 自动恢复，双方都开、不永久锁死；
bus-off 期间 `0x110~0x114` 自然断流 → Jetson 按**反馈超时 100 ms** 处理（与串口看门狗语义一致）；
诊断用 `candump -td can0`（时间戳）/ `candump -l can0`（存盘）与 F407 的 TEC/REC/LEC 打印
（注意 `CANTEST_SERIAL_DEBUG` 必须设 0——USART1 已被 `chassis_debug` 占用）。

### 15.9 can_link 实现要点（F407 侧）

| 文件 | 作用 |
|---|---|
| `UserLib/Comm/can_link_config.h` | 帧 ID、位时序、队列深度、错误阈值、`CAN_LINK_ENABLE` 开关 |
| `UserLib/Comm/can_link.h` | 对外只有三个入口：`can_link_init()` / `can_link_poll()` / `can_link_state()` |
| `UserLib/Comm/can_link.c` | CAN 帧 ↔ 12 B/40 B 协议帧的搬运、TX 队列、错误监测 |

**核心设计：协议零重写**。`can_link` 只做搬运，协议字段、CRC、校验、看门狗全部复用串口版：

```
0x020 (8B) ──► 拼出 12B 命令帧（flags 取自 0x021）──► ulink_apply_cmd12()
40B 反馈   ──► 按 8 字节切 5 帧 ─────────────────────► 0x110 ~ 0x114
```

为此在 `uart_link` 里抽出四个复用入口：

| 函数 | 作用 |
|---|---|
| `ulink_apply_cmd12(const uint8_t *f)` | 施加一帧 12 B 命令（帧头 + CRC 校验 + 命令落地） |
| `ulink_build_fb_frame(uint8_t *out, uint32_t now)` | **只组** 40 B 反馈，不发送 |
| `ulink_tick_watchdog(uint32_t now)` | 看门狗（两条链路共用同一套超时状态，重复调用无害） |
| `ulink_set_extra_status(uint16_t bits)` | 传输层向 `status` 注入额外位（供 `CAN_ERR` 用） |

**好处**：命令落地、CRC、看门狗、30+ 个字段语义**只有一份实现**，串口与 CAN 行为天然一致，
不会出现「串口能跑、CAN 有偏差」的分裂。

| CAN 帧 | DLC | 映射规则 |
|---|---|---|
| `0x000` | **任意（含 0）** | 拼 12 B 帧 `cmd = ULINK_CMD_ESTOP` → 急停（退小陀螺→停车→断 STBY→锁存） |
| `0x020` | **必须 8** | `[cmd, seq, vx(2), vy(2), wz(2)]` → 12 B 帧的第 4~9 字节；DLC < 8 直接丢弃并计入 `rx_short` |
| `0x021` | ≥ 1 | 只更新 `s_flags`，**不产生命令帧** |

**发送策略：TX 队列连续发**（对应 §15.7.4 风险 ②）——维护 **20 帧深**环形队列，主循环每轮 pump：
`while (队列非空 && 邮箱有空) AddTxMessage()`；**只有成功才推进 tail**，失败原样留着、**不丢帧**；
反馈**整组进队列或整组丢弃**，绝不发残缺组。

**两个容易踩的语义细节**：

1. **`0x021` 是标志帧，不是命令帧**：`EN` 被清 0 时 F407 立即停车，但**不**走 `ulink_apply_cmd12()`
   （否则反馈里 `cmd_cnt` 会莫名 +1，破坏上位机丢包率统计），直接调 `chassis_stop()`，
   并**故意不刷新** `s_ctrl_seen`（EN=0 不是控制帧，看门狗应照常计时）；
2. **`cmd_cnt` 统计口径**：只统计 **`0x020` 与 `0x000`**；`0x021`（无论 EN 是 0 还是 1）**都不计入**。
   上位机算丢包时按「自己发出的 `0x020` 帧数」比对。

### 15.10 联调步骤与实测记录

**建议顺序**：①F407 `CANTEST_ENABLE=1` 烧录 → `candump` 看到 `0x7F0` 心跳；②双向回显 `cansend can0 200#01`
→ 收 `0x201`；③`CanChassisLink` 上线 → 看到 `0x020`/`0x021` 与 `0x110~0x114`；④故意丢帧/插帧验组规则；
⑤ZDT 切 CAN 模式（1 Mbps）→ 扩展帧应答；⑥速度命令 **50 mm/s 起步**逐步加。

#### 15.10.1 2026-10-21 第一轮（CANable 2.0 ↔ F407）

| 项 | 结果 |
|---|---|
| 发 | `0x020` + `0x021` 正常上总线（candump 可见） |
| 收 | `0x110~0x114` 拼回 40 B，`valid=1`；组间隔 ~9.2 ms（≈100 Hz）、组内延迟 ~100 µs（远小于 2 ms 承诺） |
| status | `0x00D3`：IMU 在线+标定+驱动使能+**LINK_OK** |
| 组规则 | 自检 `[8]` 全绿（顺序/乱序/缺帧/CRC 坏组/非反馈帧） |

联调中修掉的两个 Jetson 侧问题：①`CanTransport` 的 socket 没设非阻塞 → 一读就阻塞、主循环卡死（已加 `O_NONBLOCK`）；
②`0x020` 用严格 `>= 10ms` 判断，因调度抖动隔一拍才发（~20 ms/帧）→ 加 0.9x 容差恢复 ~10 ms/帧。

#### 15.10.2 2026-10-21 第二轮（全 CAN 定案）

CANable 换机器后 `/dev/ttyACM*` 变成 `ttyACM1`；当时 CH340 未插 → 混合模式无法启动。
**据此定案（v0.4）：全部改 CAN** —— 云台 ZDT 也走同一根 `can0`（1 Mbps、面板/上位机切 CAN 模式），
上位机改 `--device can0`，CH340 彻底退役（仅留作备份/调试）。好处：少一根 USB 串口、少一层 CH340 抢线、
带宽余量充足（§15.7.3 约 10%）。
切换顺序建议：①ZDT 面板/上位机 → CAN 模式 + 1 Mbps；②`candump can0` 确认扩展帧应答；
③Jetson `--device can0`；④先使能，速度 50 mm/s 起步。

#### 15.10.3 2026-10-21 第三轮：接线修复后全链路通过

**条件**：F407 `CAN_LINK_ENABLE=1`；`slcand -o -s8 -t hw`（1 Mbps）；`can0` UP。

① **F407 → Jetson 反馈（100 Hz）**：抓 2 秒 997 帧（`0x110`×200 / `0x111`×200 / `0x112`~`0x114`×199），
完整组 199/200、**CRC 通过 199/199**、组内延迟 0.06~0.13 ms、组间隔 ≈9.97 ms。单组字节：

```
110  [8]  5A A5 81 00 00 00 00 00    帧头 + 类型 0x81 + seq + x[0..3]
111  [8]  00 00 00 00 B2 FF 00 00
112  [8]  00 00 00 00 66 00 00 00
113  [8]  51 00 00 00 BE 3B 00 00
114  [8]  00 00 00 00 00 00 5A 0D    帧尾 0x0D
```

解码（静止）：`status = 0x0051`（IMU_ONLINE + DRIVER_ON + GYRO_ON）、`cmd_cnt = 0`、里程计 x=0 / y=0 / yaw=−0.78°、
正解速度全 0、四轮 RPM 全 0。

② **Jetson → F407（双向确认）**：发 `0x021#00` + 3 帧 `0x020`（零速度）→ `cmd_cnt` **0→3** 精确对应；
`LINK_OK` 点亮；**`0x021` 不计入 `cmd_cnt`**（与 §15.9 约定一致）；`status = 0x0055`（含 `WDOG`，
因为发完 3 帧后停手超过 100 ms，符合预期）。

③ **云台 ZDT（同一根总线）**：**addr 1（yaw）正常应答**（母线 54.83 V / status 0x03 / 编码器 33959），
addr 2~16 无应答。**结论**：11-bit 标准帧（底盘）与 29-bit 扩展帧（ZDT）在同一根 1 Mbps 总线上混跑
**互不干扰**，§15.7 的隔离设计得到实测验证。总线当前 3 节点（F407 + CANable + ZDT yaw），
断电量 `CAN_H ↔ CAN_L` 约 60 Ω（4 节点全接入时应 ~40 Ω）。

### 15.11 CAN 适配器选型（避免重复踩坑）

| 型号 | Linux 支持 | 结论 |
|---|---|---|
| **CANable 2.0 / candleLight**（STM32F072/G431） | 内核自带 `gs_usb` 或 `slcan`，插上即 `can0` | ✅ **推荐**，无需任何厂商驱动 |
| KCANBus-U-I（鲲弘）`0483:000D` 原生模式 | 厂商驱动表只有 `0c72:xxxx`，只能 `new_id` 强绑；强绑后 USB 初始化全部超时（`err -110`），netdev 能注册但**一帧都发不出去** | ❌ 不可用 |
| 同上，切 `AD50:60C4`（SLCAN 模式） | 枚举为 CDC+HID 复合设备，但**不响应标准 LAWICEL 指令**（`V`/`C`/`S8`/`O` 均零字节返回），`slcand` 无法驱动 | ❌ 不可用 |

**Jetson 侧现状**：内核 4.9.253-tegra 已含 `CAN_GS_USB`/`CAN_SLCAN`/`CAN_PEAK_USB`/`CAN_8DEV_USB`；
但 **mttcan 只支持 Tegra194**（Xavier/Orin），Jetson Nano 是 t210、设备树无 CAN 节点，
**无法使用板载 CAN**，必须外接 USB 适配器。

⚠️ **遗留隐患**：`99-kcan-usbpro.rules` + `kcan-usbpro.service` 会对任意 `0483:000d` 执行 `new_id` 强绑并重启服务；
只在用鲲弘设备时才需要，长期建议 `systemctl disable --now kcan-usbpro.service`，避免误抓设备。
CAN FD 在 Jetson 内核 4.9 上用不了（`gs_usb` 是 2016 年的老版本），本项目只需 1 Mbps 经典帧，不受影响。

### 15.12 复盘：CAN 全静默（CAN_H / CAN_L 接反，2026-11-01）

**现场**：F407 + 扩展板（TJA1050）已上电，Jetson 侧 CANable2（SLCAN）`can0` 正常 UP，
`CAN_LINK_ENABLE=1`（无 100 Hz 无条件发 `0x110~0x114`），但 `candump` **一帧都收不到**。

**排除过程**：适配器/速率（`slcand -s8` vs BTR 反读，都是 1 Mbps）/固件版本（10-18 旧 bin → 重烧 51 KB 新固件）
逐层排掉，仍静默；`-s6`（500k）交叉验证错误计数仍为 0 → **线上根本没有显性位**。

**关键证据：SWD 直接读 CAN1 寄存器**（必须**先 `reset run` 让它跑一会儿再 `halt`**，
否则复位瞬间读到的全是默认值、会误判成「没初始化」）：

```bash
openocd -f interface/cmsis-dap.cfg -f target/stm32f4x.cfg \
  -c "init; reset run; sleep 1500; halt" \
  -c "mdw 0x40006400 8"      # MCR MSR TSR RF0R RF1R IER ESR BTR
  -c "mdw 0x40006580 12"     # 三个 TX 邮箱
  -c "resume; exit"
```

| 寄存器 | 值 | 含义 |
|---|---|---|
| `MCR` | `0x00010040` | `INRQ=0`（正常模式）、`ABOM=1` |
| `MSR` | `0x00000908` | `INAK=0`、`SLAK=0` → 控制器确实启动了 |
| `BTR` | `0x001A0002` | BRP=3 / TS1=11TQ / TS2=2TQ → **1 Mbps ✓** |
| `ESR.LEC` | `3` | **Acknowledgment error：没有节点应答** |
| `ESR.TEC` | `128` | 已进入 error-passive |
| `TSR.TME0/1/2` | 全 `0` | **三个发送邮箱被占满，帧发不出去** |
| `TI0R/TI1R/TI2R` | STID = `0x110/0x111/0x112` | 排队的就是反馈帧，内容正确 |

结论链：**固件正常启动 → 帧已排进邮箱 → 但总线上没人 ACK → 同时 Jetson 看到一条完全空闲的线**。
两个方向都「看不见对方」，只可能是**物理层**。

**根因与电气表现**（不是「收到乱码」而是「什么都收不到」）：发送节点把显性位反着打到线上，
对端读到的仍是隐性 → 看到一条永远空闲的总线 → `candump` 0 帧、`ip -s` 错误计数 0
（**与「线断了」表现一样，不能靠这个区分**）；发送节点收不到自己的 ACK → `LEC=3`、`TEC` 爬到 128、
邮箱一直不释放。**所以只量通断、量 5 V 是查不出来的，必须确认 `H`↔`H`、`L`↔`L` 的对应关系。**

**处理**：对调 `CAN_H`/`CAN_L` → 重插适配器 USB（`/dev/ttyACM0` 与 `by-id` 会重建）→ 重建 `can0`
→ `candump -tz can0` 看到 `0x110~0x114` 五帧轮转 = 通了；再 `cansend can0 020#...` 看底盘响应即双向可用。

**顺带确认的三件事**：①ZDT 步进出厂 **500 kbps**，在 1 Mbps 总线上不会应答，属正常现象，
**不能用它判断总线好坏**；②`can_link` 的反馈是 `can_link_poll()` 里无条件 100 Hz 发的，
所以「静默」几乎等价于「没跑这套固件」或「物理层不通」；③笔记本侧 `openocd` 需要 root（USB 权限），
DAPLink 用 `interface/cmsis-dap.cfg`、ST-Link 用 `interface/stlink.cfg`。

另有一条误判陷阱：`cansend` 能收到自己发的帧是 **SocketCAN 本地回环**（raw socket 默认回显），
**不代表总线上有节点**；所以 `can_test` 的回显判定必须靠「ID+1」，不能靠「收到了自己发的 ID」。

## 16. 上位机工程：Jetson `~/gimbal`

> 本节说明上位机正式工程与**底盘库的对接关系**。云台本身的完整说明以该工程自己的 `README.md` 为准。
> ⚠️ **本节数据是 2026-10 的快照**（UDP v1、鼠标控制、`yaw=2/pitch=1`、pitch 限位 ±45°）；
> 之后代码已演进：**UDP 协议升 v2（上行 24 B / 下行 64 B，带底盘字段）**、云台改**方向键**控制、
> 电机地址改为 **yaw=1 / pitch=2**、pitch 软限位 **−30~+30°**、新增水弹波箱 GPIO 火力控制。
> 涉及上位机细节请以 `gimbal/README.md` 与代码为准。

| 项 | 值 |
|---|---|
| 位置 | Jetson Nano `~/gimbal`（笔记本有同源副本） |
| 平台 | L4T R32.6.1 / Ubuntu 20.04 / kernel 4.9.253-tegra / aarch64 |
| 语言 / 构建 | C++17（g++ 8.4.0）+ CMake 3.16.3，单进程守护式，无 RTOS / ROS |
| 控制对象 | 云台 ZDT X42S 闭环步进 ×2（UART 115200 8N1 或 CAN 扩展帧） |
| 控制入口 | UDP 40001（PC 客户端）+ stdin（本地调试） |
| 底盘部分 | **已落地**：UART `UnifiedSerial`（与云台共用串口）或 CAN `CanChassisLink`（§16.7） |
| 外部依赖 | **零第三方库**——仅 C++ 标准库 + Linux 系统调用（termios / SocketCAN / BSD socket） |

### 16.1 分层架构与单拍数据流

```
main.cpp      100 Hz 控制循环 · stdin 交互 · UDP 收包/发遥测
Gimbal        双轴协调 · 两级看门狗 · 传输层 poll 去重
Axis          角速度斜坡 · 死区 · 软限位 · 回中 · 角度估计
ZdtMotor      物理量 ↔ ZDT 帧 · 遥测轮询 · 状态解析 · 单位换算
ITransport    发送节流队列 · 流式解析 · 按地址路由的收帧队列
  ├── UnifiedSerial  当前主用（底盘帧 + ZDT 帧共用一个 fd，RxDemux 分流）
  ├── CanTransport   扩展帧拆包重组（ZDT 走 CAN 时用）
  └── FakeTransport  纯软件模拟电机（--selftest 用）
```

**换总线只换一个实现类，上面四层一行不改**——这是分层最主要的收益。

单拍数据流（`Gimbal::step(dt)`，dt 默认 10 ms）：UDP/stdin 指令 → `Axis::setRate()`（限幅 + 重置 `since_cmd_s_`）
→ `Axis::update(dt)`（①看门狗 ②斜坡 ③死区 ④软限位+角度积分）→ 输出 °/s 换算电机 RPM（×gear÷6）
→ `ZdtMotor::setSpeedRpm()` → `ITransport::send()`（12 ms 节流队列）→ UART/CAN。
收方向：字节 → `zdt::Parser` 流式切帧 → 按 Addr 路由 → `ZdtMotor` 解析 → `Gimbal`/`Axis` 查询
→ `main` 组装遥测 → UDP 下行。`Gimbal` 只对**去重后**的传输层调 `poll()`，避免同一串口被 poll 两次。

### 16.2 ZDT 电机协议要点（Emm5.0）

**帧格式**：`Addr | 功能码 | 命令数据 | 校验码`，校验码出厂固定 **0x6B**（可改 XOR/CRC-8/Modbus/DMX512）。

| 码 | 名称 | 作用 | 码 | 名称 | 作用 |
|---|---|---|---|---|---|
| `F3` | Enable | 使能 / 失能 | `36` | GetPos | 实时位置回读 |
| `F6` | Speed | 速度模式 | `3A` | GetStatus | 状态标志位 |
| `FD` | Position | 位置模式 | `39` | GetTemp | 驱动温度 |
| `FE 98` | EStop | 立即停止 | `24` | GetVbus | 母线电压 mV |
| `FF 66` | SyncMove | 多机同步触发 | `42` | GetConfig | 驱动参数（33 B） |
| `35` | GetSpeed | 实时转速回读 | `0A` | ZeroPos | 当前位置清零 |

`0x3A` 状态位：`bit0` 使能 · `bit1` 到位 · `bit2` 堵转 · `bit3` 堵转保护 · `bit4` 左限位 · `bit5` 右限位 · `bit7` 掉电。

**⚠️ Emm 与 X 两套固件单位不同，混用必然错位**：

| | **Emm5.0**（本工程） | X |
|---|---|---|
| 位置命令 4 字节 | **脉冲数** | 0.1° 角度 |
| 速度单位 | RPM | 0.1 RPM |
| 位置回读 `0x36` | **0~65535 = 一圈 0~360°**（单圈，拿不到多圈绝对值） | 角度 / 10 |
| 位置模式帧长 | 13 字节 | 不同 |

本工程默认走**速度模式**，天然绕开位置换算；位置模式只实现了 Emm 分支。
**角度估计的诚实边界**：因为 `0x36` 只有单圈值，`Axis::estAngleDeg()` 是**转速积分出来的软件估计**、会缓慢漂移；
真正的绝对保护要靠驱动板限位开关（状态位 `bit4/bit5`）或定期 `zeroHere()` 在机械零点重新对齐。

### 16.3 六条关键设计决策（每条都来自踩坑）

| # | 决策 | 教训 |
|---|---|---|
| 1 | **命令节流 12 ms**（CAN 侧 2 ms，无粘包问题） | 手册要求帧间延时；实测两条命令间隔 0 ms 时都回复的成功率仅 **1/5**，≥1 ms 即 5/5 |
| 2 | **`urgent` 是插队不是清空队列** ⭐ | 曾实现成 `txq_.clear()`，导致 `estop()` 里 `yaw` 排入的「失能」被 `pitch` 的 clear 清掉，**yaw 永远没被失能**。多机共总线时致命 |
| 3 | **`Gimbal::enable()` 必须幂等** ⭐ | 每包都带 `Enable`（语义=保持使能），若不幂等则上电空档永远走不完，表现是「发什么都是 0，但状态全绿」 |
| 4 | **看门狗只归零、不失能** | 手感层 `rate_hold_s`(0.12 s) 无新指令→指数衰减到 0；安全层 `command_timeout_s`→强制 hold **但保持使能**。云台失能就松轴、受重力垂下来比继续转更危险 |
| 5 | **遥测轮询每项独立计时** | 不能用轮转指针（会让状态冻结再跳变）；每项各持 `next_ms`，初始值错开 5 ms 避免同拍成簇 |
| 6 | **显式 `Disable` 标志** | 只有 `Enable` 时操作端没法显式失能（「不发送」≠「失能」）；补 `0x40 Disable`，与 `Enable` 互斥且优先 |

### 16.4 UDP 操作端线协议

**两端必须逐字节一致、全部小端、用显式字节偏移写编解码**（不依赖结构体布局/padding，跨编译器跨架构不出错）。

- **v1（2026-10 的快照，仍可解码）**：上行 16 B（`magic` / `seq` / `yaw_cdps` / `pitch_cdps` / `flags` / `chk`
  逐字节 XOR / `pad`）；下行 32 B（`echo_seq` / 实际角速度 / 电机 RPM / 输出角 / 母线电压 / 温度 / `status` /
  `rx_hz` / `chk16` 累加和）。
- **v2（当前）**：上行 **24 B** / 下行 **64 B**，v1 的 16 字节前缀不变，尾部追加**底盘字段**
  （`chassis_vx_mmps` / `chassis_vy_mmps` / `chassis_wz_mradps` / `chassis_flags`）。
- 上行 `flags`：`0x01` Enable · `0x02` Hold · `0x04` Home · `0x08` Zero · `0x10` EStop · `0x20` ClearStall ·
  `0x40` Disable · `0x80` Fire（水弹扳机）。
- 下行 `status`：`0x01` Enabled · `0x02` YawOk · `0x04` PitchOk · `0x08` Watchdog · `0x10` YawLim ·
  `0x20` PitchLim · `0x40` Stall · `0x80` EStop。

**为什么用 UDP**：控制包极小（100 Hz 下约 1.6 KB/s）；**无队头阻塞**（丢包直接丢，等重传更糟）；
**无连接状态**（客户端崩溃/重连不需握手）。丢包容忍与时效判断交给两端看门狗。

### 16.5 传动比换算（最容易算错）

`--gear` 的语义是 **电机转数 / 输出轴转数**（2:1 减速填 `2.0`）：

```
输出 °/s  →  电机 RPM :   rpm = dps × gear / 6      （2:1 时 90 °/s → 30 RPM）
电机 RPM  →  输出 °/s :   dps = rpm × 6 / gear
脉冲 / 输出圈         :   pulses_per_motor_rev × gear
```

`pulses_per_motor_rev = 200 × 细分`，细分 16 → **3200 脉冲/电机圈**；自检用断言锁死
`90 °/s @ gear=2.0 → 电机 30.0 RPM`。
机械约束：yaw 有导电滑环、**360° 无机械限位**（软限位默认关闭）；pitch 有软限位
（快照值 ±45° 为估计值，**现行代码已改为 −30~+30°**，且 pitch 为直连传动、`--pitch-gear` 默认 1.0）。

### 16.6 构建、运行与本地命令

```bash
cd ~/gimbal && cmake -S . -B build -DCMAKE_BUILD_TYPE=Release && cmake --build build -j4
ctest --test-dir build            # = ./build/gimbal --selftest，纯软件自检
./build/gimbal --device /dev/ttyUSB0      # 真机（底盘 + 云台共用 CH340）
./build/gimbal --chassis can0             # 云台串口 + 底盘 CAN
./build/gimbal --device can0              # 全 CAN
```

本地 stdin 命令：`y <dps>` / `p <dps>` / `r <y> <p>` 设角速度 · `h` 停手 · `home` 回中 · `zero` 归零 ·
`en 0|1` 使能 · `x` 急停 · `s` 状态 · `q` 退出 · `f 1|0` 开/停火 · `c <vx> <vy> <wz>` 底盘速度 · `cx` 底盘急停。
配套 PC 客户端 `~/gimbal_ctl`（原生 X11 + libjpeg，协议头直接复用不复制）：`./build/gimbal_ctl --host 192.168.2.2`。

### 16.7 与底盘库的对接点（已落地）

| 文件 | 角色 | 状态 |
|---|---|---|
| `include/gimbal/link/chassis_link.hpp` | `IChassisLink` 抽象 + 帧常量 / `ChassisCommand` / `ChassisState` / 编解码纯函数 | ✅ 与 F407 `uart_link_config.h` 逐字节对齐，selftest [6] 用 Python 生成的向量锁死 |
| `include/gimbal/link/unified_serial.hpp` | 单串口统一链路：底盘帧与 ZDT 帧共用一个 fd（`RxDemux` 分流） | ✅ 已实现 |
| `include/gimbal/link/can_chassis_link.hpp` | CAN 底盘链路（SocketCAN 标准帧）+ `CanFbGroup` 反馈组拼装 | ✅ 已实现并实测（§15.10.1，selftest [8]） |
| `include/gimbal/transport/can_transport.hpp` | ZDT 电机改走 CAN 的传输层（29-bit 扩展帧拆包重组） | 帧封装按手册实现，**待上机** |

`IChassisLink` 是**全项目唯一的底盘接入点**：主程序只认 `setCommand()` / `state()` / `poll()`，
串口↔CAN 只换实现类，UDP 链路与云台逻辑不用动。坐标约定见 §4（+x 前进 / +y 左移 / 逆时针 +wz），
上位机 `ChassisCommand` 与 UDP v2 底盘字段已按同一口径实现。

### 16.8 验证边界（诚实声明）

本节上位机数据来自 `--selftest` 输出、独立 Python 交叉验证脚本、`run.log` 实机记录与源码静态核对。
**其中「真实 ZDT 电机 + 真实云台机械」的验证在写本节时尚未进行**，所以方向极性、pitch 机械行程、
传动比在真实负载下的表现、软限位对机械的保护效果、堵转保护联动行为，当时属于**设计意图而非实测结论**。
（后续 CAN 联调已在真实总线上验证了云台 yaw 的应答与读数，见 §15.10.3。）

UDP 协议用**独立 Python 实现交叉验证**（不依赖自身 C++ 编解码），当时的用例与结果：

| 用例 | 结果 |
|---|---|
| 发 `+90 °/s` | `yaw=+90.0`，电机 `+30.0 RPM`（90×2÷6 ✓） |
| 发 `-120 °/s` | `yaw=-120.0`，电机 `-40.0 RPM` ✓ |
| pitch 撞软限位 | `st=0x27`（含 `PitchLim`）✓ |
| 断流 0.9 s | `st=0x0F`（含 `Watchdog`），速度归零，**使能位保持** ✓ |
| 显式 `Disable` | `st=0x06`，`Enabled` 位清除 ✓ |
| 急停 | 速度 0 + 已失能 ✓ |

### 16.9 当前状态与下一步

**已验证**：双平台编译通过（x86_64 + aarch64，0 error / 0 warning）；`--selftest` 全绿；
UDP 链路实机跑过（`--dry` 模拟电机）；CAN 链路三轮实机联调（§15.10）。

**待做**：①真机 ZDT 云台串口通信与方向极性标定；②pitch 实际机械行程实测；③云台 ZDT 切 CAN 模式 + 1 Mbps；
④`--device can0` 全 CAN 端到端联调；⑤双轴同步运动（ZDT 多机同步标志 + 广播触发）；⑥位置模式上机验证。

⚠️ **资源冲突提醒**：`/dev/ttyUSB0` **同一次只能被一个进程占用**，调试前必须先杀掉另一个
（如 `pkill -f test_server.py`）。

## 17. IMU（LSM6DSV16X）与陀螺偏航闭环（小陀螺）

### 17.1 硬件与接线

| 项 | 内容 |
|---|---|
| 模块 | 正点原子 ATK-MS6DSV（ST LSM6DSV16X 六轴，模块自带 4.7K 上拉） |
| 位置 | 底盘扩展板 IIC 座（H5），模块平放：丝印 **X 指车头、Y 指车体左侧、Z 向上** |
| 总线 | 3V3 供电（扩展板自带 R1/R3 两个 4.7K 上拉，与模块并联约 2.35K） |
| 接线 | 出厂时扩展板 H5 的 SDA/SCL 与模块引脚**交叉**（§17.7 坑 6），2026-10-18 已飞线改正 → 现在用**硬件 I2C1**（SCL=PB6 / SDA=PB7，400 kHz，`IMU_USE_SOFT_I2C=0`）；软件 I2C 后端保留（`=1`，SCL=PB7 / SDA=PB6）作兜底 |
| INT | **不用**（纯轮询 DATA_READY，不接中断）。线头剪短/包起来别蹭到别的网络 |
| SA0 | 2026-10-19 已**直连 GND** → 地址固定 **0x6A**。之前是弱上拉（板载 100k）会飘（§17.7 坑 11）。**不能用 100k 下拉**：会和板载 100k 上拉分压成 1.65 V，等于没接 |
| I2C 速率 | **400 kHz Fast Mode**；100 kHz 时代码自动把陀螺采样周期从 2 ms 放宽到 3 ms |

轴映射写在 `imu_config.h` 的 `IMU_MAP_X/Y/Z`（编码 = 符号 × (芯片轴号+1)，当前恒等映射）。
**验证法**：手转车体逆时针（俯视），串口 `gz` 应变正；若为负把 `IMU_MAP_Z` 取反即可，不用改接线。

### 17.2 数据链（`UserLib/IMU/imu.c`）

```
imu_poll()（跟着 1 kHz 控制环调用，内部按 2 ms 节拍限速）
   ├─ 读 OUTX_L_G（6 字节）→ 按 ±1000 dps 换算 rad/s
   ├─ 减零偏 → 轴映射到车体系 → 40 Hz 一阶低通（gyro_lpf，控制用这个）
   ├─ yaw += gyro_lpf[2] * dt（±PI 归一）
   └─ 每 10 个样本读一次加速度（只做静止/倾角参考）

imu_calibrate_bias()  上电静止标定 300 点（约 0.6 s），标准差 >0.05 rad/s 判为「车在动」→ 标记未标定
imu_track_bias()      车静止时按 τ=4 s 慢速跟踪残余零偏（车在动时完全不动）
```

- 采样率：硬件 I2C 400 kHz 下 **500 Hz**（`IMU_GYRO_PERIOD_MS=2`）；100 kHz 硬件 I2C 自动降到 333 Hz；
  实测一次 6 字节读：**硬件 400 kHz = 213 µs**，软件 I2C 兜底 = 351 µs；
- 陀螺量程 ±1000 dps：分辨率 0.03 dps ≈ 5.3e-4 rad/s，而自旋上限 4.76 rad/s = 273 dps，留 3.6 倍余量；
- 阻塞代价：一次读 213 µs、每 2 ms 一次 ≈ **10.6% CPU**（软件 I2C 那套 351 µs ≈ 17%）。
  想上 1 kHz 采样或零阻塞得改 I2C+DMA，本库暂不做。

**掉线与恢复**（2026-10-18 实测踩到过一次运行中掉线）：

| 机制 | 参数 | 行为 |
|---|---|---|
| 总线恢复 | `IMU_ERR_RECOVER_COUNT=5`、限流 `IMU_RECOVER_MIN_MS=100` | 连续 5 次读失败 → 硬件模式 `DeInit` **+ GPIO 打 9 个时钟 + STOP + Init** |
| 判掉线 | `IMU_ERR_STALE_COUNT=10`（20 ms） | `imu_state()->healthy=false`，陀螺外环**自动退回纯运动学**，不用陈旧值修正 |
| 地址热切换 | — | 读/写失败时自动换另一个地址（0x6A ↔ 0x6B）再试一次，成功就锁定并计入 `addr_switches` |
| 自动恢复 | — | 重新读通即 `healthy=true`，外环无缝接回 |
| 诊断字段 | 串口 `eps= ad= sw= rec=` | 每秒新增错误数 / 当前地址 / 换地址次数 / 总线解锁次数 |

缺了 9 个时钟那一步只 DeInit/Init 解不开：从机把 SDA 拉死时，必须给它时钟把状态机顶出来。

**20 分钟空闲 soak 对比**（`test_data/spin_runs/idle_20min.log` / `soak_after_reflow_20min.log`）：

| 版本 | 20 分钟错误数 | 形态 | 结果 |
|---|---|---|---|
| 重飞线前 | **144 次** | 集中在 t≈1100 s 的一次 0.7 s 爆发（`us` 213→27→213、`hz` 499→262→499） | 自动恢复，没进 STALE |
| 重飞线后 | 0 次 | `us` 恒 213、`hz` 恒 499 | 一次都没掉（后来又复发了） |
| **SA0 焊死 GND 后** | **0 次** | `ad` 恒 `6A`、`sw=0`、`rec=0`、`eps` 恒 0 | 4801 帧全绿，彻底解决 |

### 17.3 陀螺外环控制律（`chassis_gyro.c`）

```
wz_ref = 用户指令 / 自旋速率 / 角度环输出
e      = wz_ref − wz_gyro
wz_out = clamp( wz_ref + Kp·e + Ki·∫e , ±CHASSIS_GYRO_WZ_LIMIT )
```

四条设计约束（每条都来自踩坑，别随手删）：

1. **只修正不替代**：前馈仍是 `wz_ref`，陀螺只补打滑/擦地的差额，所以 IMU 掉线会退回纯运动学而不是失控；
2. **斜坡段冻结修正**：用「上一拍实际轮速目标 vs 逆解目标」判断斜坡还在爬，此时外环沿用上一拍修正量。
   不冻结的话起步瞬间 `Kp·e`（3.5×0.6=2.1）会把 wz 顶到限幅——仿真里无打滑时自旋峰值冲到 4.29 rad/s（超调 23%）；
3. **能力带 `CHASSIS_GYRO_I_BAND`**：`|e|` 超过它也冻结（大误差 = 物理上还没追上）。必须大于最大预期打滑误差：
   30% 打滑 @3.5 rad/s ≈ 1.05 rad/s，所以给 2.0；
4. **条件积分抗饱和**：输出顶 `CHASSIS_GYRO_WZ_LIMIT` 且误差还在同方向推时，本拍不积分。

外环输出限幅 `CHASSIS_GYRO_WZ_LIMIT = 4.60` 比用户指令限幅 `CHASSIS_MAX_WZ_RAD_S = 4.0` 高，
因为自旋要补偿打滑，物理上限是 `250RPM × 0.10472 × 0.04 / 0.2201 ≈ 4.76 rad/s`。

### 17.4 模式与接口

| 模式 | 用途 | 入口 |
|---|---|---|
| `CHASSIS_GYRO_MODE_OFF` | 不参与，wz 直接用指令（排错退路） | `chassis_gyro_set_mode()` |
| `CHASSIS_GYRO_MODE_RATE` | 角速度闭环：用户 wz 当目标，陀螺做修正（**默认**） | `chassis_set_velocity()` 照常调用 |
| `CHASSIS_GYRO_MODE_SPIN` | 小陀螺：恒定自旋速率 | `chassis_spin(rad_s)`，`chassis_spin(0)` 退出 |
| `CHASSIS_GYRO_MODE_YAW_TARGET` | 偏航角闭环：底盘转到指定角 | `chassis_gyro_set_yaw_target(rad)` |

状态镜像在 `chassis_state()`：`imu_wz`（陀螺实测）、`imu_yaw`（陀螺积分）、`wz_eff`（实际下发）、`imu_online`。

**云台跟随（预留，尚未接入）**：接云台时只需

```
底盘目标角 = 云台世界角 = imu_yaw + 云台相对底盘角
chassis_gyro_set_mode(CHASSIS_GYRO_MODE_YAW_TARGET);
chassis_gyro_set_yaw_target(gimbal_world_yaw);
```

云台相对角从云台 yaw 电机编码器来，底盘库不关心它从哪来。小陀螺本身（底盘恒速自旋 + 云台反向补偿）不需要这个接口。

### 17.5 验证现状

**PC 对象仿真**（轮速斜坡 + 一阶电机滞后 + 打滑系数 + 陀螺噪声）：

| 场景 | 稳态误差 | 峰值 | 说明 |
|---|---|---|---|
| 自旋 3.5 无打滑 | <0.001 rad/s | 3.503 | 无超调 |
| 自旋 3.5 打滑 18% | −0.003 rad/s | 3.500 | 外环补 0.76 rad/s |
| 自旋 3.5 打滑 30% | −0.28 rad/s | 3.220 | 顶 4.6 限幅，属物理极限 |
| 自旋 1.5 / 0.5 | <0.001 rad/s | 目标值 | 低速也一样 |
| 自旋 −3.5（反向） | +0.003 rad/s | −3.500 | 符号正确 |

**2026-10-18 实机**：握手 `imu ok`、WHO_AM_I=0x70；采样（硬件 I2C 400 kHz 飞线后）`hz=499`、`us=213`（连抓 12 s 不变）；
零偏标定后 `gz` 在 ±0.001 rad/s 内；平放时 `ac=(0.33,0.43,9.89) m/s²` → 「X 前 / Y 左 / Z 上」映射正确。
手转逆时针 → `gz` 单调为正（峰值 +1.06 rad/s）、陀螺积分 yaw −97°→+78°，**轴映射与符号正确**；
同一手转里四轮自动反着给 ±78 RPM、积分 0.8 s 顶到 `I_MAX×KI=1.6`，抗旋转扰动方向正确；
手转停止后静止 4 s 内陀螺积分 yaw 完全不动。实验 5 四轮架空：目标 ±3.5 rad/s → 四轮 **±184 RPM**
（手算 183.9 ✅），且**电机 PWM 对 I2C 零干扰**（转动中陀螺噪声 std 0.0014 rad/s，静止 0.0004）。

**噪声实测**（静止、1 kHz 原始值、±1000 dps / ±4 g）：`gz` std **0.028 dps = 0.49 mrad/s**
（40 Hz 低通后 0.34 mrad/s）；等效噪声密度 ≈1.3 mdps/√Hz（手册典型 2.8，正常水平）；加速度噪声 20~25 mm/s²；
零偏逐块重复性 0.003 dps。**上电后约 5 s 内 x/y 噪声明显变大**（gx 峰峰 11 dps），所以零偏标定延后到 **1.2 s**
（`IMU_STARTUP_SETTLE_MS`），上电到能跑车约 1.8 s。

**漂移实测**（静止 130 s）：陀螺积分 yaw 显示 `0°`（<1°）；按零偏块间重复性推算约 **0.1~0.3 °/min**。
> 对比量级：四轮测速量化噪声约 ±2 RPM ≈ **±0.21 rad/s**，是陀螺噪声（0.0005 rad/s）的 **400 倍**——
> 陀螺是整个底盘库里最干净的速度反馈，外环用它稳赚。

**地面自旋实测（2026-10-19 首轮，数据受污染不作闭环指标）**：`+3.5 rad/s` 段满占空比也只到 2.0~2.6 rad/s
（四轮被推到 −211/+242 RPM、`duty=1000‰` 顶满）→ **3.5 rad/s 超出该地面的抓地极限**（麦轮自旋要横向擦地，损耗大）；
`−3.5` 段轮速精准到位但车体不转 → 现场确认车被卡住，数据作废。
调参结论：地砖上约 **2.0~2.5 rad/s（120~145°/s）** 是稳态上限，`CHASSIS_SPIN_RATE_RAD_S` 因此从 3.5 **下调到 2.0**。

**还没做的**：真实打滑率、落地自旋的稳态误差/纹波、yaw 长时间漂移。用 §6.8 实验 5 抓数据
（`CHASSIS_TUNE_ENABLE=1` + `CHASSIS_TUNE_EXPERIMENT=5`），四段各 2 s，看 `ch1−ch0` 的稳态差与纹波，
再用 `tools/spin_analysis.py <log>` 一键算指标。

### 17.6 踩坑记录

| # | 坑 | 现象 | 教训 |
|---|---|---|---|
| 1 | 浮点常量用在 `#if` | 编译报 `floating constant in preprocessor expression` | 配置里的 `40.0f` 只能进运行期 `if` |
| 2 | 外环 P 项在起步瞬间顶满 | 自旋峰值 4.29 rad/s（目标 3.5） | 斜坡/大误差段冻结修正 |
| 3 | 冻结条件只挂 `ramping` | 稳态打滑 18% 永远补不回来（停在 3.35） | 冻结条件必须同时挂误差带 |
| 4 | 误差带取 1.0 太窄 | 30% 打滑（误差 1.05）掉在带外，永远不积分 | 带宽 > 最大打滑误差 |
| 5 | ST 官方驱动 I2C 读多字节 | 给寄存器地址置 0x80 会读到错误寄存器 | I2C 模式不置 0x80，靠 IF_INC 自增（并显式 `auto_increment_set`） |
| 6 | **H5 座上 SDA/SCL 交叉**（已飞线） | 硬件 I2C1 对 0x6A/0x6B 全部 NACK（`Err=0x04` AF），全总线 0 设备，但引脚电平与外设寄存器全对 | 用**软件 I2C 两种引脚角色各扫一遍**：SCL=PB6/SDA=PB7 → 0 个；交换后 **0x6B ACK、WHO_AM_I=0x70** → 板子把 SDA/SCL 接反了 |
| 7 | 软件 I2C 用 `HAL_GPIO_WritePin` | 一次读 6 字节要 **1285 µs** | 改 `BSRR` 直写 + DWT 周期计数延时 → **351 µs** |
| 8 | 上电就标零偏 | 上电 ~5 s 内陀螺 x/y 噪声偏大，0.7 s 标定会被污染 | `IMU_STARTUP_SETTLE_MS=1200` |
| 9 | 飞线后 SWD 提速到 1 MHz 会掉 | 写 flash 报 `Failed to write memory`，500 kHz 正常 | 检查 SWD 那 4 根线（尤其 GND），烧录用 `adapter speed 500` |
| 10 | IMU 运行中突然掉线 | 串口仍 `imu ok` 但 `us=27 hz=0 ac=0,0,0`（地址阶段就 NACK），复位能恢复 | 恢复流程必须**先 DeInit 再用 GPIO 打 9 个时钟**；连续失败要判 `healthy=false` 让外环退回 |
| 11 | **SA0 弱上拉 → 地址漂移** | 运行中大量 27 µs 快速 NACK，错误计数暴涨，控制环掉拍，偶发一阵后自恢复 → 复发 | 根因是 SA0 没拉死。**直连 GND（0 Ω 或 ≤1k）**，不要 100k（会与板载 100k 上拉分压成 1.65 V） |

### 17.7 复盘：IMU 地址应答不稳 → 底盘电机「一卡一卡」（2026-10-19）

**现象**：无线遥控驱动时四轮**一卡一卡**（走走停停）；Jetson 侧 F407 反馈只有 **57 Hz**（正常 100 Hz，
p90 帧间隔 51.7 ms）；UART1 调试口读到 `e=1496722` 且 ≈280~520 次/秒增长、`us=27`、`CAL=0`。

**证据链**：单次读耗时 **27 µs** = 400 kHz 下地址字节 9 bit ≈22.5 µs → **在地址阶段就被 NACK**，不是 3 ms 超时；
错误计数 149 万；采样节拍 499 仍正常；反馈帧率 57 Hz（1 kHz 控制环掉拍 ≈40%）。

**根因**：①**地址应答不稳**（启动时探测到 0x6B，运行期约一半事务在地址字节被 NACK，
嫌疑指向 SA0 悬空导致地址在 0x6A/0x6B 间漂移，`IMU_PROBE_BOTH_ADDR=1` 双地址探测正好掩盖了它）；
②**阻塞式恢复雪上加霜**（`imu_bus_recover()` 用 `HAL_Delay(1)` 连打 20 多下、每次约 25 ms、限流 100 ms 一次，
另有部分失败走满 3 ms 超时）；③调试串口每 250 ms 阻塞约 17 ms。

**修复**：

| 文件 | 改动 | 效果 |
|---|---|---|
| `imu.c` | `plat_read/plat_write` 失败时**换 0x6A/0x6B 另一个地址重试一次**，成功则锁定（`imu_alt_addr()`） | `e`：150 万 → **0** |
| `imu.c` | 新增 `dwt_delay_us()`；`hw_bus_unstick()` 的 `HAL_Delay(1)` 全换 10 µs 忙等 | 恢复耗时 25 ms → **0.24 ms** |
| `chassis_debug.c/.h` | 调试发送改 `HAL_UART_Transmit_IT` + 缓冲 + 忙标志（发不完丢帧） | 每 250 ms 不再阻塞 17 ms |
| `uart_link.c` | `HAL_UART_TxCpltCallback` 里转发 `chassis_debug_on_tx_cplt()` 清忙标志 | — |
| `usart.c` / `stm32f4xx_it.c` | 补 USART1 NVIC（优先级 7）与 `USART1_IRQHandler` | `Transmit_IT` 能真正发出去 |

**验证**：`e=0`、`us=214 µs`、`hz=499`、`CAL=1`；UART1 `t=` 间隔精确 250 ms；Jetson 侧 200/201 帧 CRC 全对、2 s 内 ≈100 Hz。
**给 IMU 负责人的建议**：①先查 SA0 硬件电平（焊死一个电平最干净）；②运行时记下应答地址并支持热切换，
`imu_state` 里加「当前地址 / 每秒新增错误数 / 恢复次数」；③阻塞式恢复必须改 µs 级或下放低优先级任务；
④调试输出补「错误类型（AF/BERR/ARLO）」。

### 17.8 A/B 诊断：关断陀螺外环（排查「原地转向顿挫」）

**现场（2026-11）**：`Q/E` 原地转向呈「打嗝式」周期性停走，而 `W/S` 前进**平顺**。

**先做的排除**：前进与转向走同一条命令通道（CAN `0x020` 100 Hz + F407 100 ms 看门狗），前进平顺
⇒ 命令链路、看门狗、CAN 总线都不背这个锅（Jetson 侧 `can0` 统计也确认 `errors=0 / dropped=0 / overrun=0`）。
剩下两个嫌疑：

| 嫌疑 | 机理 | 判别 |
|---|---|---|
| **机械擦地粘滑** | 麦轮原地转时四轮横向擦地，接触点「粘住—滑动」交替；前进是纯滚动所以平顺 | 关外环后仍顿 → 是它 |
| **陀螺外环放大打滑** | 打滑 → 陀螺读到偏低 → 外环加修正 → 轮速更高、擦地更凶 → 打滑更多 | 关外环后变顺 → 是它 |

**踩到的坑：`CHASSIS_GYRO_ENABLE` 是死宏**——定义在 `chassis_config.h` 里但**全工程无人引用**，改成 0 也照旧跑外环；
只改 `CHASSIS_GYRO_MODE_DEFAULT` 也没用，因为 `uart_link` 每收一帧都会调 `chassis_spin(0.0f)`，那个分支会**强制切回 RATE**。
已在 `chassis_gyro.c` 的 `init()` / `set_mode()` 两处补 `#if`，开关真正生效（`=1` 行为不变）。

**编一个诊断版**（与正常版并行，不动正常版配置）：

```bash
# ① 临时把 CHASSIS_GYRO_ENABLE 改成 0
cmake -S . -B build/DiagNoGyro -G Ninja \
      -DCMAKE_TOOLCHAIN_FILE=cmake/gcc-arm-none-eabi.cmake -DCMAKE_BUILD_TYPE=Debug
ninja -C build/DiagNoGyro
arm-none-eabi-objcopy -O binary \
      build/DiagNoGyro/INTRA_SCHOOL_COMPETITION_27RM.elf \
      build/DiagNoGyro/INTRA_SCHOOL_COMPETITION_27RM_nogyro.bin
# ② 把 CHASSIS_GYRO_ENABLE 改回 1，重建正常版
```

镜像只差 4 B（52752 B vs 52748 B），**别拿大小当区分依据**，按文件名用；想确认诊断版真关断了，
反汇编 `chassis_gyro_set_mode` 会多一条 `movs r3, #0`。

**判定与后续**：①诊断版还打嗝 → 机械擦地粘滑，换地面（光滑瓷砖最容易粘-滑）、调转向转速（`--chassis-turn` 800/2200 各试）、
加轮压；②诊断版明显变顺 → 外环在放大打滑，先降 `CORR_MAX`（1.5 → 0.6）收紧补偿量再看稳态误差；
③另一变量是**架空测试**（四轮离地把「地面」摘掉），与关外环组合即成完整隔离。

⚠️ 诊断版两个**预期内的假异常**，别当新 bug：没有外环补打滑、同样指令转得明显更慢；小陀螺自旋会失效（模式被强制 OFF）。

## 18. USART2 上位机控制链路（`UserLib/Comm/uart_link`）

> 这是**实际跑车用的控制入口之一**（串口版）。CAN 正式链路 `can_link`（§15）与它协议逐字段一致，
> 命令落地 / CRC / 看门狗共用同一份实现。模块用法速查在 `UserLib/Comm/README.md`。

### 18.1 拓扑与数据流

```
Jetson Nano / 笔记本（USB-TTL，115200-8-N-1）
        │  PD5(TX) -> F407 RX     PD6(RX) <- F407 TX
        ▼
USART2 RX 中断（逐字节）→ 256 B 环形缓冲 → uart_link_poll() 切帧
        │  CRC 校验 + 命令字分发
        ├─ SPEED  → chassis_spin(0) + chassis_set_velocity(vx, vy, wz)
        ├─ SPIN   → chassis_spin(wz)
        ├─ ESTOP  → chassis_spin(0) + chassis_stop() + chassis_driver_enable(0)
        └─ CLEAR  → chassis_reset_odometry() + chassis_gyro_reset()
        │
        └─ 反馈帧 40 B / 10 ms → USART2 发回 Jetson
```

### 18.2 命令帧（Jetson → F407，**12 B**，全部小端）

| off | 0 | 1 | 2 | 3 | 4..5 | 6..7 | 8..9 | 10 | 11 |
|---|---|---|---|---|---|---|---|---|---|
| 字段 | `0xA5` | `0x5A` | `cmd` | `seq` | `vx` i16 | `vy` i16 | `wz` i16 | `flags` | `crc8` |
| 单位 | — | — | 见下表 | 递增 | mm/s | mm/s | 0.01 rad/s | 位域 | — |

- `vx/vy`：**+x 前进 / +y 左移**（与 §4 一致）；`wz`：0.01 rad/s，逆时针为正
- `crc8`：CRC-8/ATM（poly 0x07，init 0x00，不反射），覆盖 **offset 0~10**
- `flags`：bit0 `EN` = 允许驱动；`EN=0` 时命令帧只刷新看门狗，目标速度被清零

| cmd | 名称 | 作用 |
|---|---|---|
| `0x01` | SPEED | `vx/vy/wz` 直接下发；执行前先 `chassis_spin(0)` 退出自旋（SPIN 会无视用户 wz） |
| `0x02` | ESTOP | 退出自旋 → 清速度 → **拉低 STBY**（电机自由）；需下一帧带 `EN` 的 SPEED/SPIN 才能恢复 |
| `0x03` | SPIN | `wz` 字段当自旋速率 → `chassis_spin(wz)`（小陀螺） |
| `0x04` | CLEAR | 里程计 (x,y,yaw) + 陀螺积分 yaw 一起归零 |

### 18.3 反馈帧（F407 → Jetson，**40 B**，10 ms 一帧 = 100 Hz）

| off | 字段 | 类型 | 单位 |
|---|---|---|---|
| 0..1 | 帧头 `0x5A 0xA5`（与命令帧**方向相反**，便于重同步） | u8×2 | — |
| 2 | 类型码 `0x81` | u8 | — |
| 3 | 最近一次合法命令的 `seq` 回显 | u8 | — |
| 4..7 / 8..11 | 里程计 `x` / `y` | i32 | mm |
| 12..13 | 里程计 `yaw` | i16 | 0.01° |
| 14..15 / 16..17 | 正解速度 `vx` / `vy` | i16 | mm/s |
| 18..19 | 正解角速度 `wz` | i16 | 0.01 rad/s |
| 20..21 / 22..23 | 陀螺积分 `yaw` / 陀螺实测 `wz` | i16 | 0.01° / 0.01 rad/s |
| 24..25 | `status`（见下） | u16 | 位域 |
| 26..27 | `cmd_cnt` 累计合法命令帧数（低 16 位，上位机算丢包） | u16 | — |
| 28..29 | `fb_seq` 反馈帧自身序号（算接收率） | u16 | — |
| 30..37 | 四轮实测转速 FL/FR/BL/BR | i16×4 | 0.01 RPM |
| 38 | `crc8`（覆盖 offset 0~37） | u8 | — |
| 39 | 帧尾 `0x0D` | u8 | — |

`status` 位：

| 位 | 名称 | 含义 | 位 | 名称 | 含义 |
|---|---|---|---|---|---|
| 0x0001 | IMU_ONLINE | IMU 在线且配置成功 | 0x0010 | DRIVER_ON | TB6612 STBY 高（输出使能） |
| 0x0002 | LINK_OK | 最近 100 ms 内收到过合法控制帧 | 0x0020 | SPIN | 小陀螺模式 |
| 0x0004 | WATCHDOG | 控制帧超时，目标速度已清零 | 0x0040 | GYRO_ON | 陀螺外环非 OFF |
| 0x0008 | ESTOP | 急停锁存中 | 0x0080 | IMU_CAL | 陀螺零偏标定有效 |
| 0x0100 | CAN_ERR | CAN 总线错误（TEC/REC > 96，由 `can_link` 注入，§15.8） | | | |

### 18.4 看门狗与安全约定

| 层级 | 触发 | 动作 | 参数 |
|---|---|---|---|
| 控制层 | 100 ms 没有合法 SPEED/SPIN 帧 | 目标速度强制清零（经斜坡减速）+ 置 `WATCHDOG`；**不失能、不松 STBY** | `ULINK_CMD_TIMEOUT_MS=100` |
| 提示层 | 500 ms 连一帧合法命令都没有 | 置 `LINK_LOST`（只作状态显示，停车已在上一层完成） | `ULINK_CMD_LOST_MS=500` |
| 急停 | ESTOP 命令 | 退出自旋 + 清速度 + 拉低 STBY，锁存 | 需带 `EN` 的帧恢复 |

**为什么不超时就失能**：底盘/云台一旦松轴，受自重和惯性甩动比继续停着更危险（同 §16.3 决策 4 的云台结论）。

### 18.5 接口与统计

```c
uart_link_init();      /* main() 里 chassis_init() 之后 */
while (1) { chassis_poll(); uart_link_poll(); }
const uart_link_state_t *s = uart_link_state();   /* 只读统计 */
```

| 统计字段 | 含义 | 什么时候该看 |
|---|---|---|
| `rx_frames` / `last_seq` | 累计合法命令帧 / 最近 seq | 上位机算丢包率 |
| `rx_crc_err` | CRC 失败次数 | 持续增长 = 干扰/波特率/线长问题 |
| `rx_sync_err` | 帧头对不上的字节数 | 增长 = 丢字节后重同步 |
| `rx_hw_err` | ORE/FE/NE 硬件错误 | 增长 = 波特率或电气问题 |
| `rx_overflow` | 环形缓冲溢出丢字节 | **只有主循环被卡住才会出现**，是「掉拍」的直接证据 |
| `tx_frames` / `tx_drop` | 已排入发送 / 因上一帧没发完丢掉 | `tx_drop` 增长 = 串口发不动 |
| `cmd_speed` / `cmd_unknown` | 速度帧 / 未知命令字计数 | 排查上位机发错命令 |
| `wdg_trips` | 看门狗触发次数 | 链路抖动的量化指标 |

### 18.6 与底盘库的单位换算

| 链路量 | 底盘量 | 换算 |
|---|---|---|
| `vx/vy` (i16) | `chassis_set_velocity(vx, vy, wz)` (m/s) | ×0.001 |
| `wz` (i16) | wz (rad/s) / `chassis_spin(rad_s)` | ×0.01 |
| 反馈 `x/y` (i32 mm) | `chassis_state()->x / y` (m) | ×1000 |
| 反馈 `yaw/wz` | 里程计 / 陀螺 | 0.01° / 0.01 rad/s |

坐标约定与 §4 一致，上位机发帧前**不需要再做转换**。

### 18.7 PC 端验证

| 工具 | 用途 |
|---|---|
| `tools/uart_link_test.py` | 生成测试向量 / 独立 Python 实现交叉校验（不依赖 C 代码） |
| `tools/codec_test.c` | PC 上用 gcc 编译 `uart_link_codec.h`，做编解码双向自检 |

实测（2026-10-19）：100 Hz 反馈稳定，`cmd_cnt`/`fb_seq` 连续，200/201 帧 CRC 全对；
IMU 地址应答问题（§17.7）修好后，「反馈掉到 57 Hz」的现象消失。

### 18.8 踩坑

| # | 坑 | 现象 | 教训 |
|---|---|---|---|
| 1 | CubeMX 没勾 USART2 全局中断 | 一个字节都收不到，`rx_bytes` 恒 0 | `stm32f4xx_it.c` 里必须有 `USART2_IRQHandler`；`.ioc` 的 `NVIC.USART2_IRQn` 要打勾，否则重新生成会丢 |
| 2 | 主循环里有长阻塞 | `rx_overflow` 增长、丢帧 | 256 B 环形缓冲在 100 Hz×12 B = 1.2 KB/s 下只够**约 200 ms** |
| 3 | 改了字段没同步两端 | 上位机读数乱跳 | CRC 覆盖范围（命令 0~10 / 反馈 0~37）、偏移、单位必须与 `uart_link_codec.h` 和 PC 侧逐字节对齐 |
| 4 | 帧头方向 | 反向帧头容易被误认 | 命令 `0xA5 0x5A`、反馈 `0x5A 0xA5` 故意相反，切帧先判方向再校验 |
| 5 | 自旋模式忽略用户 wz | 发了 SPEED 车不按指令平移 | `uart_link` 里 SPEED 执行前先 `chassis_spin(0)` |

### 18.9 复盘：看门狗误触发 → 轮速周期性「打嗝」（2026-11）

**现象**：架空和落地都一样，前进与原地转向都会**大约每 2.2 s 出现一次 50~150 ms 的四轮同步掉速**，
然后自己恢复；按 Q/E 原地转时表现为「打嗝式」卡顿（前进时不易察觉）。

**排查（每条都靠数据钉死）**：地面打滑（架空照样掉）、陀螺外环（纯前进 wz=0 照样掉）、发送端卡顿
（发送间隔全程 10 ms 无空档、CAN 侧 `txfail=0`）、命令断流（`cmd_cnt` 每 10 ms 稳定 +1）、
EN 被清/急停/第二命令源（诊断帧显示 `s_flags=1`、`driver_on=1`）全部排除；
**最终 `wdg_trips` 与 `chassis_stop()` 调用计数 1:1 增长** ⇒ 看门狗误触发。
掉速下降斜率正好是 1500 RPM/s，说明是「参考速度被清零又被恢复」。

**根因（`can_link_poll()` / `uart_link_poll()` 同一个 bug）**：

```c
const uint32_t now = HAL_GetTick();   // ① 先采样
can_link_handle_rx();                 // ② 执行命令 → s_last_ctrl_ms = 更晚的 HAL_GetTick()
ulink_tick_watchdog(now);             // ③ now - s_last_ctrl_ms 为负 → uint32 下溢 ≈ 42 亿
                                      //    → 恒 > 100 ms → 误判超时 → chassis_stop()
```

**为什么是周期性 2.2 s**：主循环节拍与 10 ms 命令帧的相位缓慢漂移，撞上 SysTick 边界的那些拍会连续触发，
于是形成「一小段连续误触发 + 一段正常」的节律；命令发得越快，下一次命令来得越早、掉速越浅。

**修法（三处，缺一不可）**：①`can_link_poll()` 改传最新 `HAL_GetTick()`；②`uart_link_poll()` 同一个 bug，一样改；
③`ulink_tick_watchdog()` 差值改成**有符号**比较（`int32_t age`），任何顺序/回绕都不会再误判（双保险）。

**验证**（架空、`CANLINK_DIAG_FB_ENABLE=1` 诊断固件）：

| 项 | 修复前 | 修复后 |
|---|---|---|
| 前进 vx=600 mm/s | FL min **54** RPM、std **7.3**、`wdg_trips` **29**、掉速 3 次 | FL min **136** RPM、std **1.9**、`wdg_trips` **0**、掉速 **0** |
| 原地转 wz=1.5 rad/s | 掉速 | std 1.8、无掉速、四轮符号 **899/899 拍全对**（FL− FR+ BL− BR+） |
| 行驶中 `chassis_stop()` 计数 | 每秒涨几十 | 行驶中恒定 |

**顺带留了个排查工具**：`CANLINK_DIAG_FB_ENABLE=1` 时每 10 ms 额外发 3 帧诊断（`0x115` 四轮占空比 /
`0x116` 内部速度指令·`wz_eff`·`chassis_stop()` 计数·`s_flags` / `0x117` UART 收帧数·CRC 错·看门狗触发次数·噪声计数）。
Jetson 侧只认 `0x110~0x114`、会忽略这三帧，不影响控制；**正式版该宏保持 0**（每秒多 300 帧没必要）。

## 19. 版本记录

### 19.1 底盘库（原 `CHASSIS_LIBRARY.md`）

| 版本 | 日期 | 说明 |
|---|---|---|
| 0.1 | 2025-10-03 | 初版：motor / encoder / pid / mecanum / chassis / demo，速度闭环 + 里程计，裸机 1 kHz |
| 0.2 | 2025-10-03 | 拆分电机方向与编码器方向归一；新增 `chassis_debug`；右两轮 ENC_DIR 默认取反 |
| 0.3~0.6 | 2025-10-03 | 依串口数据整定（Kp 5→3、Ki→0.6、Kd→0.08、I_MAX→900）；加 JustFloat 协议；PID 参数改为每轮独立；加加速度前馈 Kff、BR 单独钝化 |
| 0.7 | 2025-10-06 | 适配重新布线：PWM 改 TIM5_CH2/3/4 + TIM9_CH1，编码器改 TIM1/3/4/8（全 TI12 四倍频），方向引脚换新，ENC_DIR 重置待标定 |
| 0.8 | 2026-10-09 | 仓库纳入硬件资料（`hardware/`）；**代码无改动** |
| 0.9 | 2026-10-18 | 新增 `can_test`（心跳/点灯/回显/silent-loopback/TEC·REC·LEC）；修复 `.ioc` 位时序（875 kbps × 3TQ → 1 Mbps × 14TQ）；F407 侧全链路验证合格，卡点在上位机适配器 |
| 0.10 | 2026-10-18 | 确立 Jetson `~/gimbal` 为上位机正式工程，记录 `IChassisLink` 对接点与预留协议；CAN 暂缓待适配器定案 |
| 0.11 | 2026-10-18 | 重写 §16 为上位机完整文档（工程规模/五层架构/ZDT Emm5.0 要点/六条设计决策/UDP 协议/传动比/踩坑/验证边界）；发现 `ChassisCommand` 的 vx/vy 与底盘库不一致 |
| 0.12 | 2026-10-18 | **四轮速度环实机整定**：修 FR/BR 编码器方向、开输入数字滤波（幽灵计数 146→0）、PID 重构（Kff 移入 `pid_calc`、新增 Kacc、条件积分、微分低通）、Kd 归零、Ki 0.6→40、新增 `chassis_tune`、`MAX_WHEEL_RPM` 280→250、`I_MAX` 900→20。实测 120 RPM 稳态误差 <1 RPM、超调 5~11% |
| 0.13 | 2026-10-18 | **新增 §17 IMU 与陀螺偏航闭环**：`UserLib/IMU`（I2C1 400k、双地址探测、零偏标定+跟踪、40 Hz 低通、yaw 积分、总线卡死恢复）、`chassis_gyro`（外环 PI、双冻结、能力带、条件积分、三种模式）、JustFloat 13→17 通道、整定实验 5、演示加小陀螺段 |
| 0.14~0.15 | 2026-10-18 | 文档补齐 + IMU 链路定型：新增 `UserLib/IMU/README.md`；飞线修复 SDA/SCL 交叉；软件 I2C 用 BSRR+DWT 提速（1285→351 µs）；`IMU_STARTUP_SETTLE_MS=1200`；掉线恢复改「DeInit + 打 9 个时钟 + STOP + Init」并加 `healthy` 判据 |
| 0.16 | 2026-10-19 | **定位「电机一卡一卡」**：IMU 地址应答不稳（约一半读在地址阶段被 NACK，`us≈27µs`）+ 阻塞式恢复 → 1 kHz 掉拍 30~40%、反馈 57 Hz。修地址热切换、DWT µs 忙等、调试改 `Transmit_IT` + 补 USART1 NVIC/IRQHandler。验证反馈 100 Hz、`e=0`（§17.7） |
| 0.17 | 2026-10-19 | **SA0 焊死 GND**（根因：板载 100k 弱上拉导致地址在 0x6A/0x6B 间漂移）；`imu_state` 增 `err_per_s`/`addr_switches`/`recover_count`；20 分钟 soak 4801 帧全绿（对比焊死前 144 次错误） |
| 0.18 | 2026-10-19 | **新增 §18 USART2 控制链路**：12 B 命令帧 / 40 B 反馈帧字段表、命令字、`status` 位、三级看门狗约定、统计字段、单位坐标换算、PC 验证工具与 5 条踩坑 |
| 0.19 | 2026-10-21 | **CAN 正式链路落地**：新增 `can_link`（`0x000`/`0x020`/`0x021` + `0x110~0x114`、TX 队列、`CAN_ERR`）；`uart_link` 抽出 4 个复用入口；`can_test` 改编译开关并与 `CAN_LINK_ENABLE` 互斥；坐标约定两侧统一 |
| 0.20 | 2026-11-02 | **修「按 Q/E 不原地转、先前进再画弧」**：`K_WZ` 从 `{-1,-1,+1,+1}` 改为 `{-1,+1,-1,+1}`，正解 wz 行同步改；新增 §10.3.1 复盘（§6.4 补 kw 结构规则、§14 修正推导）。**轮速/占空比标定数字全部不变** |
| 0.21 | 2026-11-02 | **修「A/D 平移方向反」**：`K_VY` 从 σ 的负号形式改为 `{-1,+1,+1,-1}`，正解 vy 行同步；`tools/uart_link_test.py` 期望符号同步（原来跟错表一起写）；新增 §10.3.2 复盘并讲清 **ky/kw 必须同源** |
| 0.22 | 2026-11-02 | **修死宏 `CHASSIS_GYRO_ENABLE`**（定义了却无人引用，且 `chassis_spin` 会强制切回 RATE）+ 新增 §17.8 A/B 诊断流程（诊断版编译命令、判定与后续、两个预期内假异常） |
| 0.23 | 2026-11-02 | **修看门狗误触发**（周期性掉速/转向卡顿）：两处 `poll()` 改传最新 `HAL_GetTick()`，`ulink_tick_watchdog()` 差值改有符号比较；新增 `CANLINK_DIAG_FB_ENABLE` 诊断帧；新增 §18.9 复盘（`wdg_trips` 29→0、FL std 7.3→1.9） |

### 19.2 CAN 对接草案（原 `CAN_CONTROL_PROTOCOL.md`）

| 日期 | 版本 | 修订 |
|---|---|---|
| 2026-10-19 | v0.1 | 初稿：背景、现状、帧表草案（命令 2 帧 / 反馈 5 帧）、ZDT CAN、确认清单 |
| 2026-10-19 | v0.2 | 波特率 1 Mbps 定案；新增 `0x000` 广播急停；补反馈组完整性规则；`0x021` 改 10 Hz+变化即发；`status` 增 `CAN_ERR=0x0100`；ABOM 自动恢复；三条技术风险；联调步骤与遗留问题 |
| 2026-10-19 | v0.3 | 发策略定案 = TX 队列连续发（组内 ≤2 ms、组超时 5 ms）；`0x000` 定为 Jetson 发/F407 只收；`CANTEST_ENABLE` 放 `can_test_config.h`；新增 §15.7.5 边界分析 |
| 2026-10-21 | v0.4 | **全部改 CAN 定案**：放弃「底盘 CAN + 云台 UART」混合方案，ZDT×2 与 F407 共用 `can0`；ZDT 由面板/上位机切 CAN 模式 + 1 Mbps；上位机改 `--device can0`，CH340 退役 |
| 2026-10-21 | v0.5 | F407 侧 6 项待办全部完成；新增 `can_link` 实现章节（协议零重写 / 4 个复用入口 / 帧映射 / 编译开关互斥 / TX 队列 / 两个语义细节 / `CAN_ERR` 阈值 / 使用与验证命令） |
| 2026-10-21 | v0.6 | 新增第三轮实测（接线修复后全链路通过）：反馈 100 Hz×5 帧、CRC 199/199、组内 0.06~0.13 ms、组间隔 9.97 ms；`cmd_cnt` 0→3 精确对应；云台 addr 1 正常应答；标准帧与扩展帧混跑互不干扰 |

### 19.3 CAN 测试文档（原 `CAN_TEST.md`）

该文档为 `can_test` 模块的使用说明，本身没有独立版本号；其内容已并入 §15.1~§15.6 与 §15.12。
