326hhh/HLJU_RMIC_chassis/hardware/SCH_Schematic1_2026-11-05.pdf

右边 42

H2

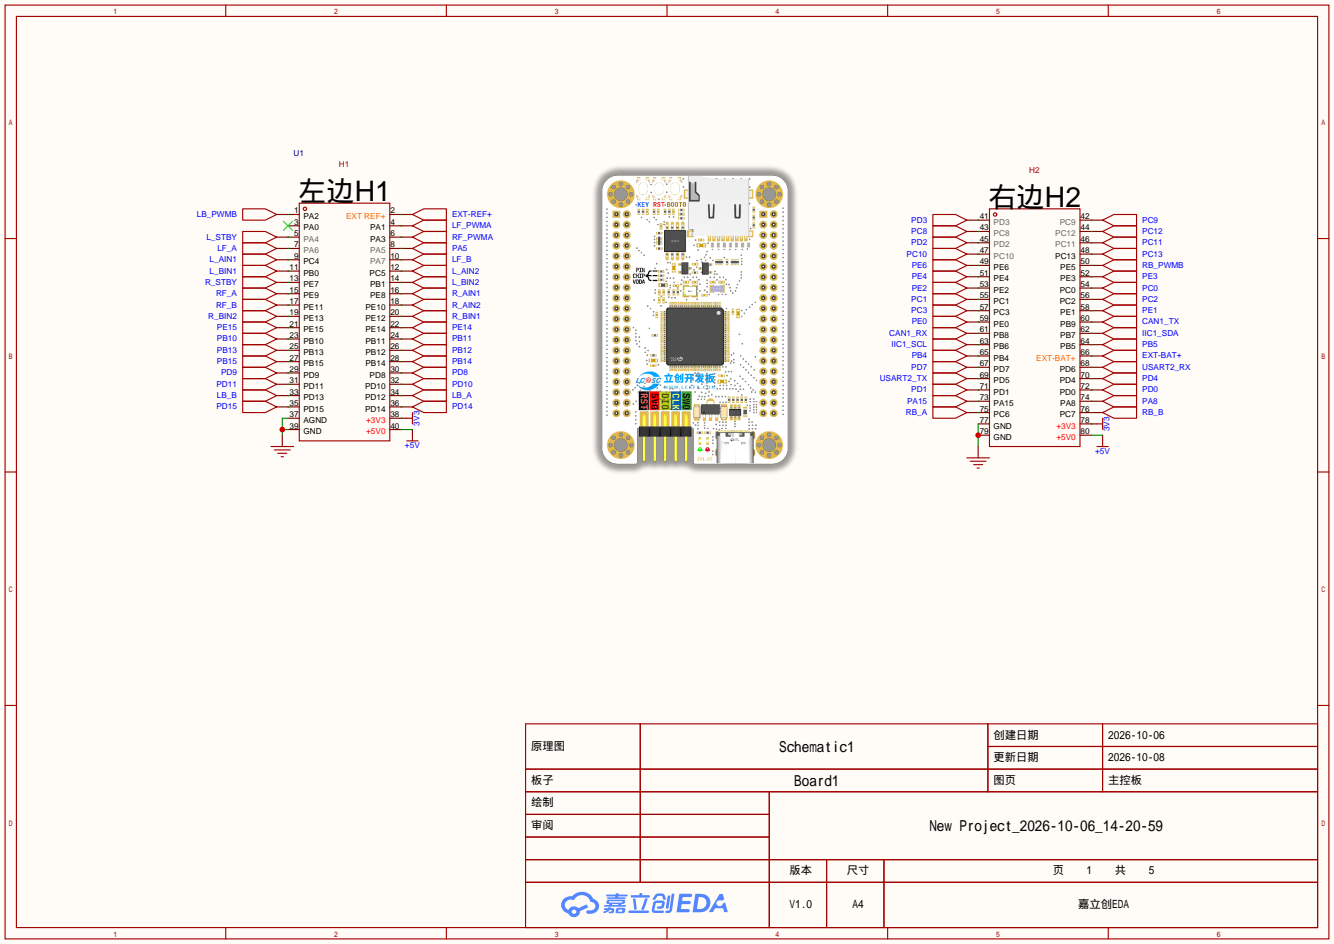
[picture p1: page 1]

原理图 | Schematic1 | 创建日期 | 2026-10-06

更新日期 | 2026-10-08

板子 | Board1 | 图页 | 主控板

绘制 | | New Project_2026-10-06_14-20-59
审阅

V1.0 | A4 | 嘉立创EDA

## 12V3V³

L

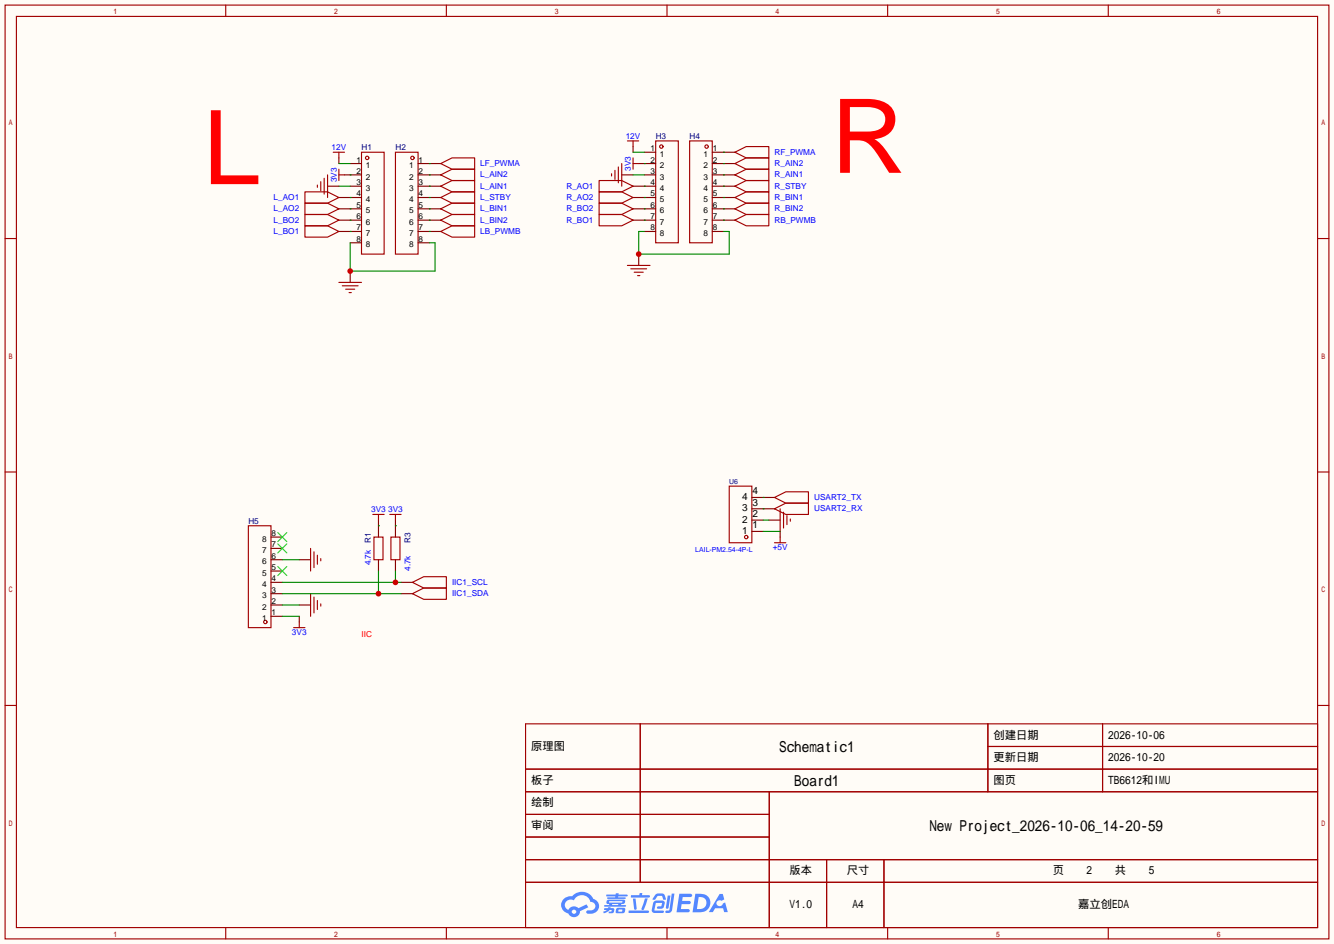
[picture p2: page 2]

原理图 | Schematic1 | 创建日期 | 2026-10-06

更新日期 | 2026-10-20

板子 | Board1 | 图页 | TB6612和IMU

绘制 | | New Project_2026-10-06_14-20-59
审阅

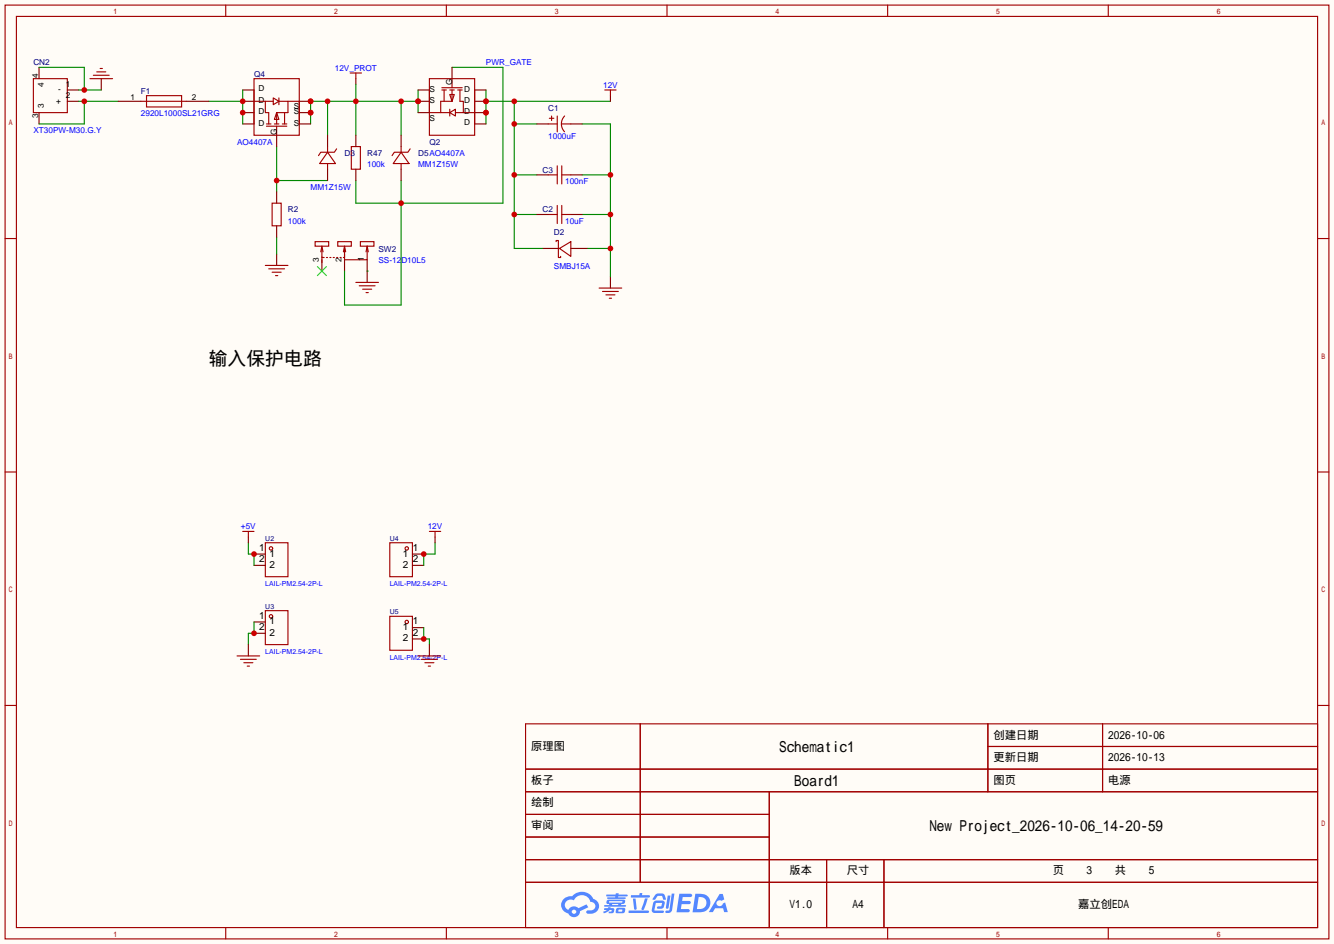
[picture p3: page 3]

原理图 | Schematic1 | 创建日期 | 2026-10-06

更新日期 | 2026-10-13

板子 | Board1 | 图页 | 电源

绘制 | | New Project_2026-10-06_14-20-59
审阅

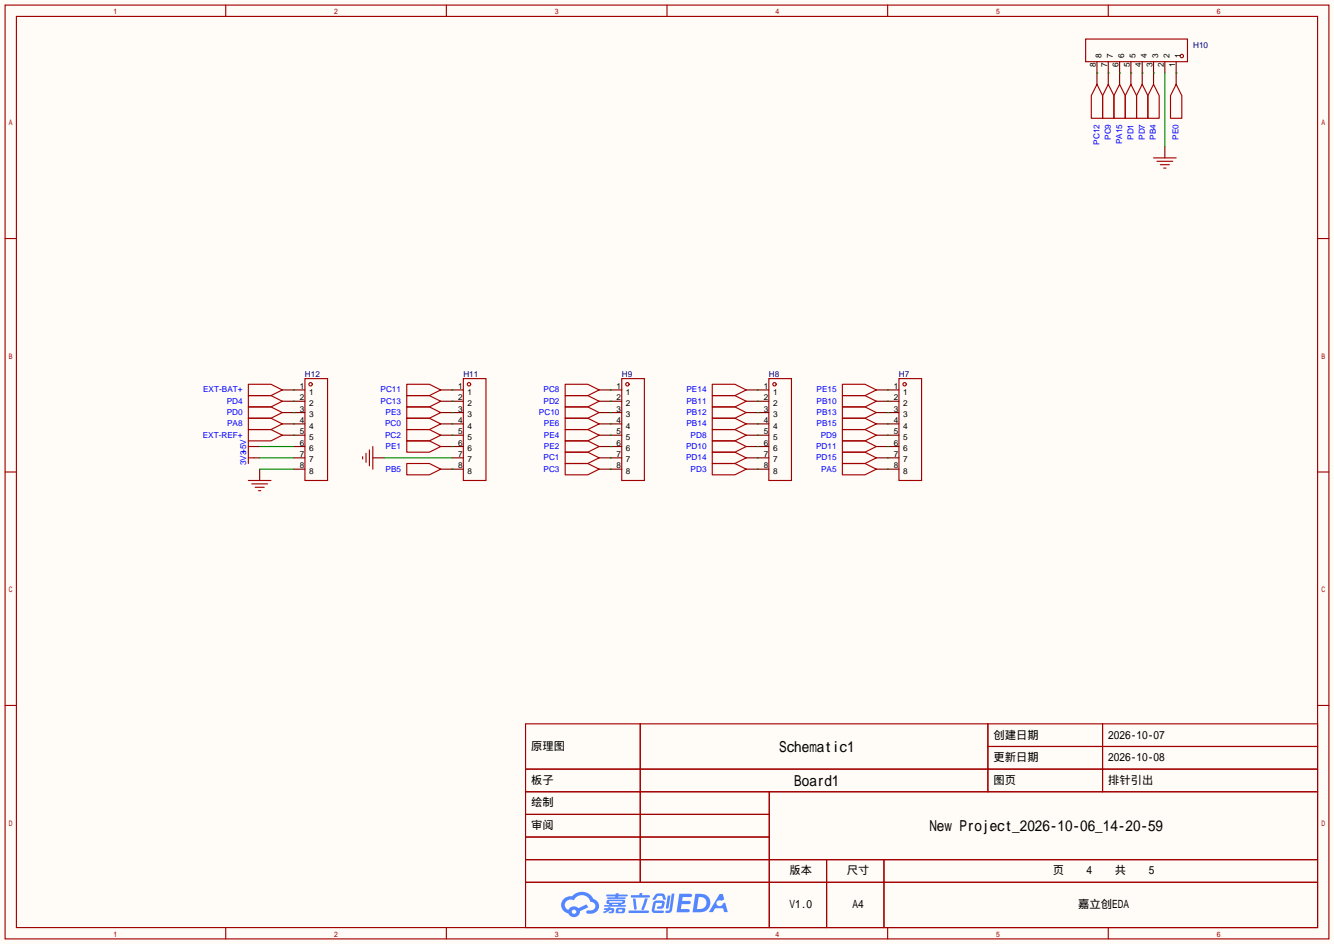
[picture p4: page 4]

原理图 | Schematic1 | 创建日期 | 2026-10-07

更新日期 | 2026-10-08

板子 | Board1 | 图页 | 排针引出

绘制 | | New Project_2026-10-06_14-20-59
审阅

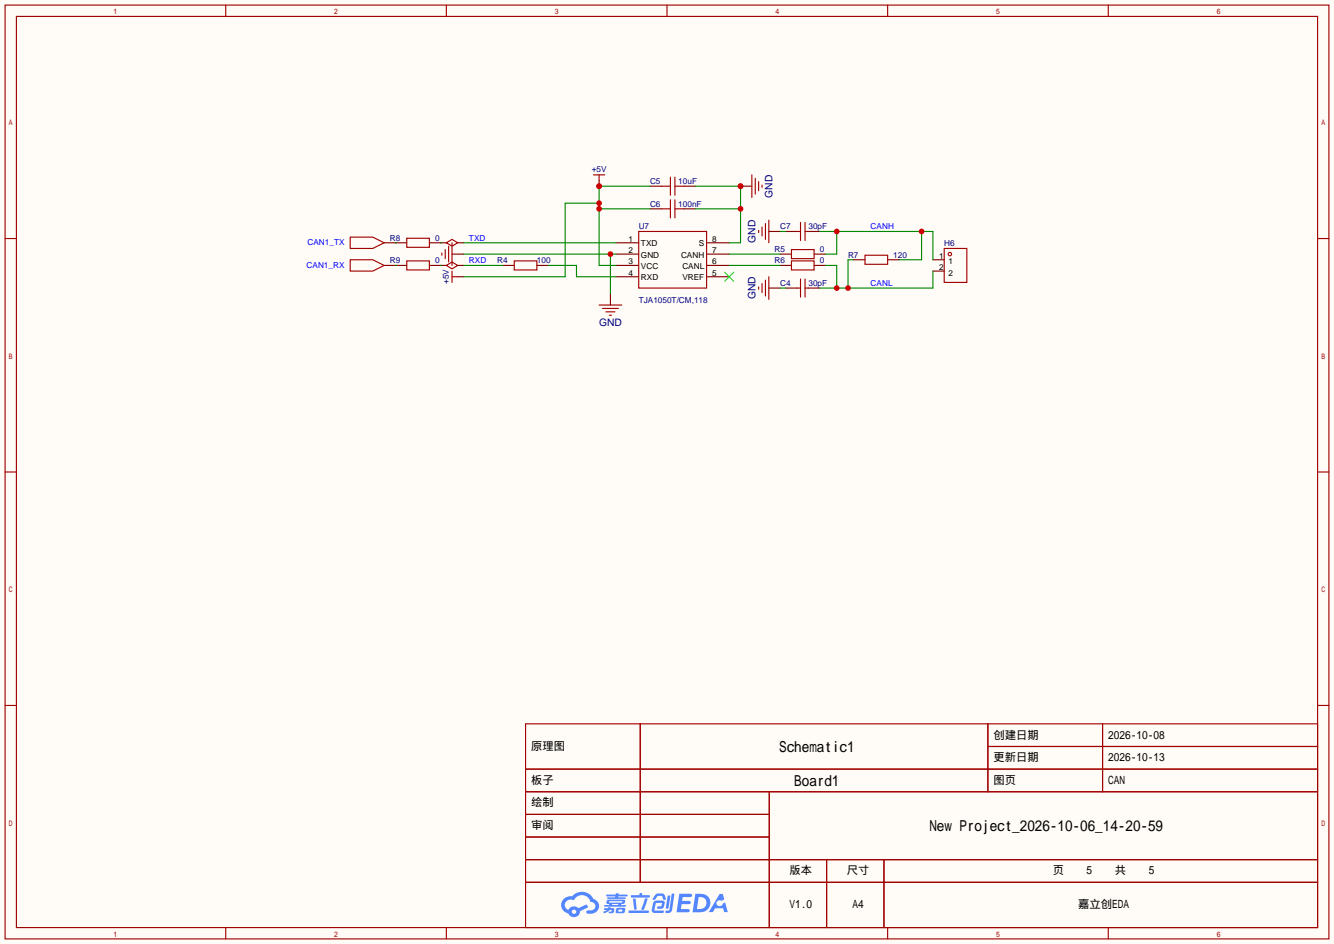
[picture p5: page 5]

原理图 | Schematic1 | 创建日期 | 2026-10-08

更新日期 | 2026-10-13

板子 | Board1 | 图页 | CAN

绘制 | | New Project_2026-10-06_14-20-59
审阅
