326hhh/HLJU_RMIC_chassis/hardware/底盘扩展板原理图_2026-10-09.pdf

右边 42

H2


原理图 | Schematic1 | 创建日期 | 2026-10-06

更新日期 | 2026-10-08

板子 | Board1 | 图页 | 主控板

绘制 | | New Project_2026-10-06_14-20-59
审阅

V1.0 | A4 | 嘉立创EDA

L

R

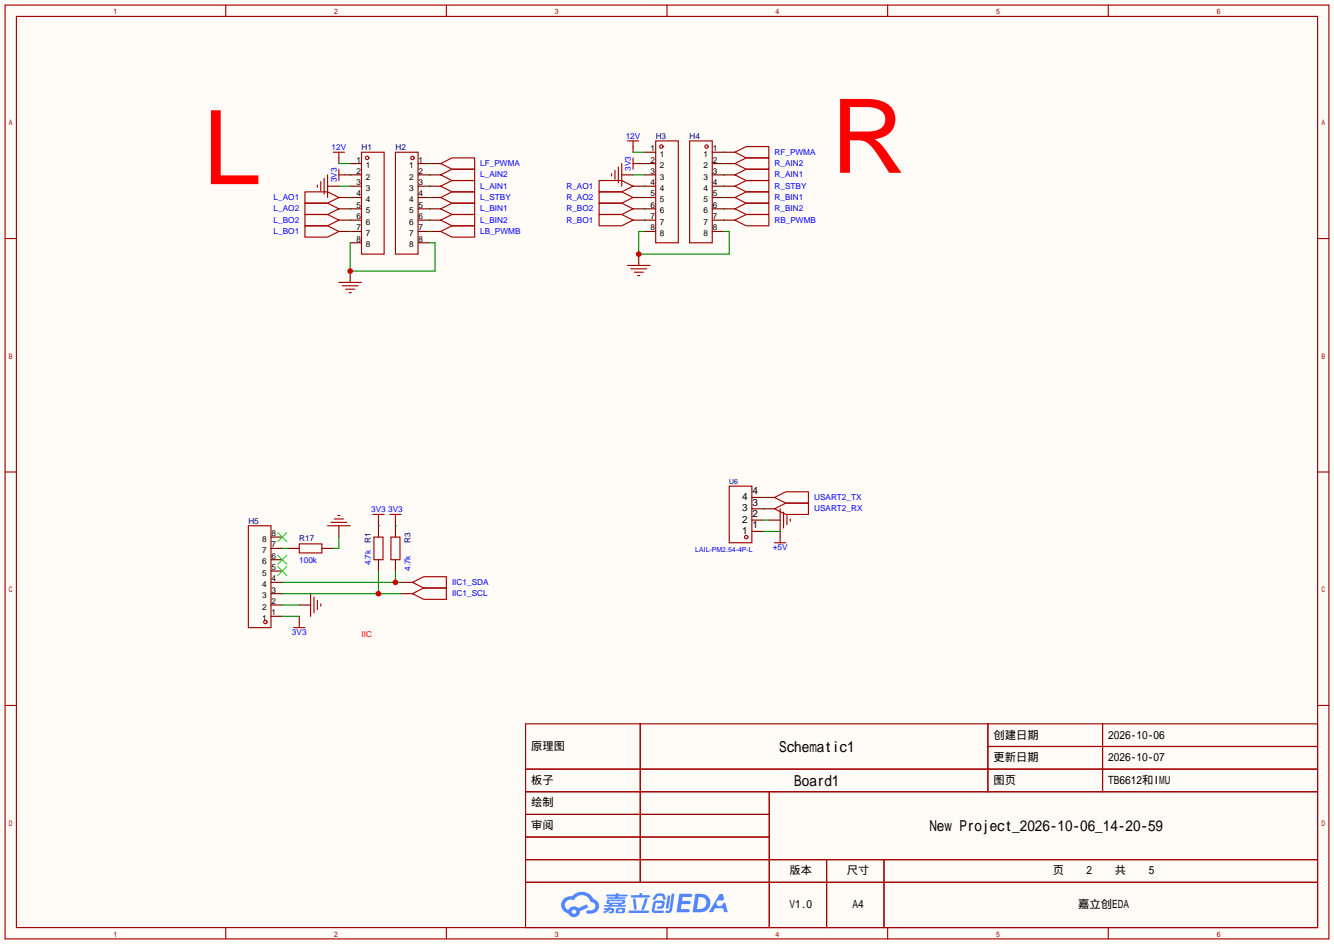
[picture p6: page 2]

原理图 | Schematic1 | 创建日期 | 2026-10-06

更新日期 | 2026-10-07

板子 | Board1 | 图页 | TB6612和IMU

绘制 | | New Project_2026-10-06_14-20-59
审阅

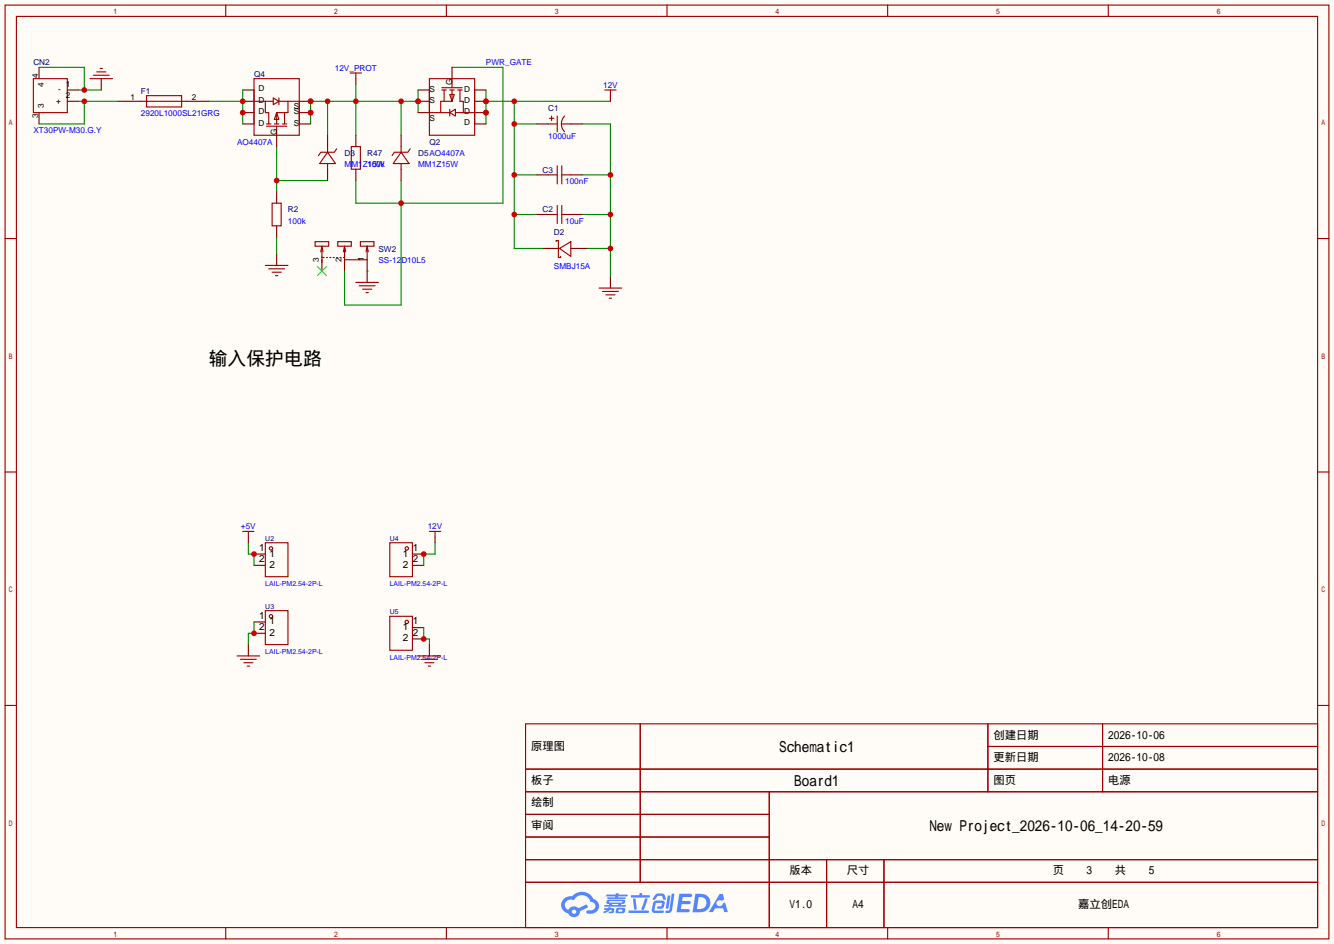
[picture p7: page 3]

原理图 | Schematic1 | 创建日期 | 2026-10-06

更新日期 | 2026-10-08

板子 | Board1 | 图页 | 电源

绘制 | | New Project_2026-10-06_14-20-59
审阅


原理图 | Schematic1 | 创建日期 | 2026-10-07

更新日期 | 2026-10-08

板子 | Board1 | 图页 | 排针引出

绘制 | | New Project_2026-10-06_14-20-59
审阅

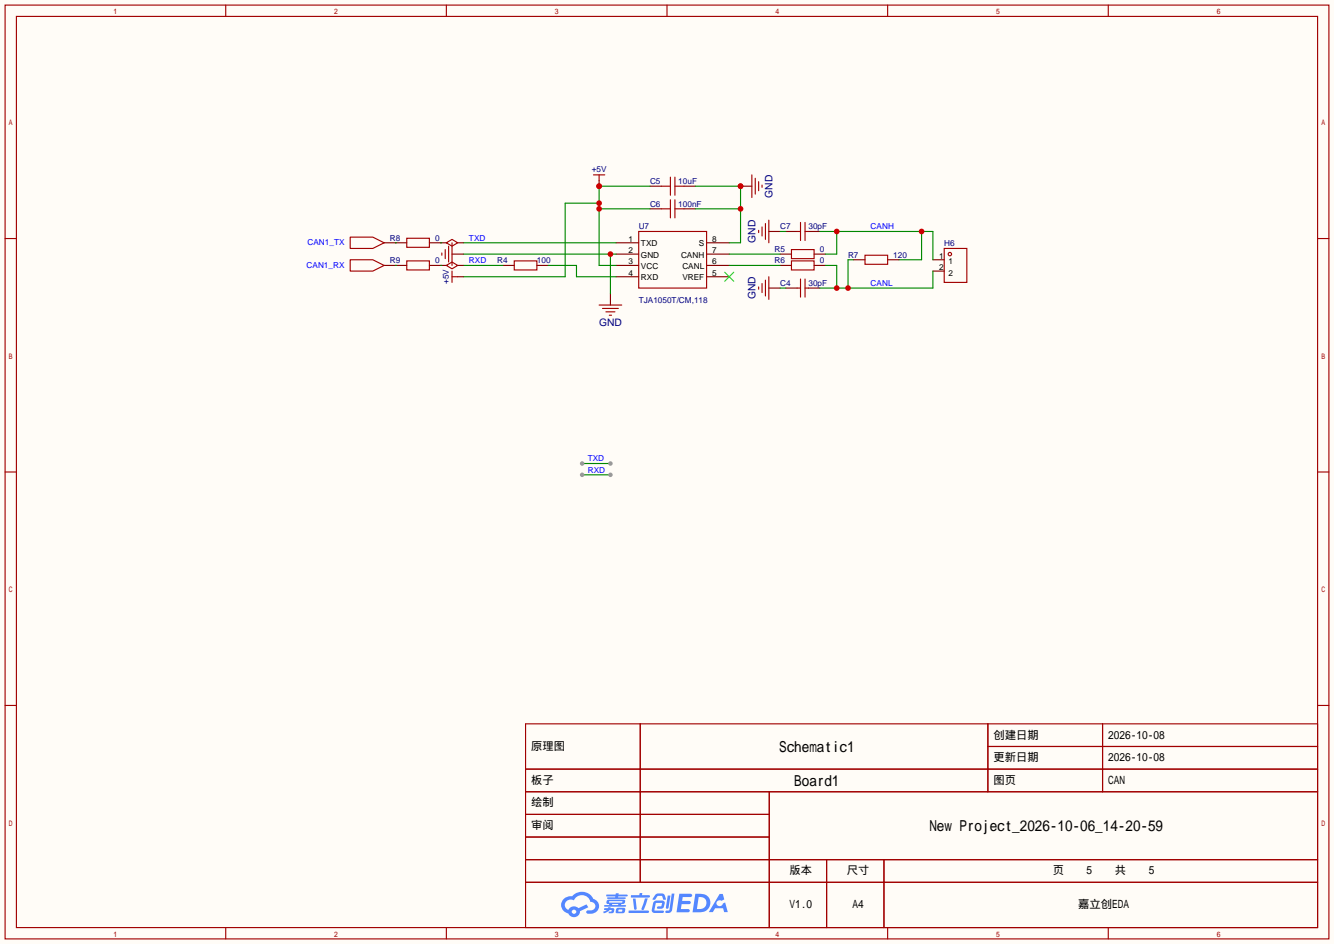
[picture p8: page 5]

原理图 | Schematic1 | 创建日期 | 2026-10-08

更新日期 | 2026-10-08

板子 | Board1 | 图页 | CAN

绘制 | | New Project_2026-10-06_14-20-59
审阅
