326hhh/HLJU_RMIC_chassis/Core/Src/main.c

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
/* Includes ------------------------------------------------------------------*/
#include "main.h"
#include "can.h"
#include "i2c.h"
#include "tim.h"
#include "usart.h"
#include "gpio.h"

/* USER CODE BEGIN Includes */
#include "chassis.h"
#include "chassis_config.h"
#include "chassis_demo.h"
#include "chassis_debug.h"
#include "chassis_tune.h"
#include "can_test.h"
#include "can_link.h"
#include "uart_link.h"
/* USER CODE END Includes */


void SystemClock_Config(void);
/**
  * @brief  The application entry point.
  * @retval int
  */
int main(void)
{

  /* MCU Configuration--------------------------------------------------------*/

  /* Reset of all peripherals, Initializes the Flash interface and the Systick. */
  HAL_Init();

  /* Configure the system clock */
  SystemClock_Config();

  /* Initialize all configured peripherals */
  MX_GPIO_Init();
  MX_TIM1_Init();
  MX_TIM3_Init();
  MX_TIM4_Init();
  MX_USART1_UART_Init();
  MX_I2C1_Init();
  MX_TIM9_Init();
  MX_USART2_UART_Init();
  MX_TIM5_Init();
  MX_TIM8_Init();
  MX_CAN1_Init();
  /* USER CODE BEGIN 2 */
  chassis_init();

  /* 上位机链路：Jetson -> USART2(PD5/PD6) -> 底盘
   * ⚠ 依赖 CubeMX 在 NVIC 里勾选 USART2 global interrupt，否则收不到数据 */
  uart_link_init();

  /* CAN 链路：两个模块都要初始化 CAN1，编译期互斥（见 can_link.c 顶部 #error）
   *   CAN_LINK_ENABLE = 1 -> 正式协议链路（联调期）
   *   CANTEST_ENABLE  = 1 -> can_test 调试工具（排障期）
   * 两个都关 = 整定期，CAN 完全不参与，不会污染 USART1 调参数据 */
#if CAN_LINK_ENABLE
  can_link_init();
#endif
#if CANTEST_ENABLE
  can_test_init();
#endif

#if CHASSIS_TUNE_ENABLE
  /* 整定模式：由 chassis_tune 接管四轮并回传实验数据 */
  chassis_tune_init();
#else
  // chassis_demo_init();
#endif

  /* USER CODE END 2 */

  /* Infinite loop */
  /* USER CODE BEGIN WHILE */
  while (1)
  {
    /* 1kHz 控制循环：chassis_poll() 内部检测 HAL tick，到点才执行一次 */
    chassis_poll();
    /* 上位机链路：收命令帧 -> 底盘；看门狗；100 Hz 回传反馈帧 */
    uart_link_poll();
#if CHASSIS_TUNE_ENABLE
    chassis_tune_poll();
#else
    chassis_debug_poll();
#if CHASSIS_DEMO_ENABLE
    chassis_demo_poll();
#endif
#endif
    /* USER CODE END WHILE */

    /* USER CODE BEGIN 3 */
    /* CAN 链路（编译期开关见 can_link_config.h / can_test_config.h） */
#if CAN_LINK_ENABLE
    can_link_poll();    /* 收命令 + 看门狗 + 100 Hz 反馈 */
#endif
#if CANTEST_ENABLE
    can_test_poll();    /* CAN 测试：心跳 + 点灯 + 回显 */
#endif
  }
  /* USER CODE END 3 */
}

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
