326hhh/HLJU_RMIC_chassis/UserLib/Chassis/chassis.h

/**
  ******************************************************************************
  * @file    chassis.h
  * @brief   麦克纳姆轮底盘主模块：指令入口 + 1kHz 控制循环 + 里程计
  *
  * 使用方式（裸机）：
  *   chassis_init();
  *   while (1) {
  *       chassis_poll();        // 内部按 1kHz tick 执行控制循环
  *       ... 其他应用逻辑 ...
  *   }
  *
  * 控制链：指令速度 -> 运动学逆解 -> 轮速斜坡 -> 速度环 PID -> TB6612
  * 反馈链：编码器 -> 滑动窗口测速 -> 运动学正解 -> 里程计
  ******************************************************************************
  */
#ifndef USERLIB_CHASSIS_CHASSIS_H
#define USERLIB_CHASSIS_CHASSIS_H

#include "mecanum.h"

#include <stdbool.h>
#include <stdint.h>

typedef struct
{
    /* ---- 指令（用户通过 chassis_set_velocity 写入） ---- */
    float cmd_vx;   /* m/s，+x 前进 */
    float cmd_vy;   /* m/s，+y 左移 */
    float cmd_wz;   /* rad/s，逆时针为正 */
    /* ---- 测量 ---- */
    float meas_vx, meas_vy, meas_wz;                    /* 正解得到的车体速度 */
    float wheel_rpm_ref[CHASSIS_WHEEL_NUM];             /* 斜坡后的目标轮速 (RPM) */
    float wheel_rpm_meas[CHASSIS_WHEEL_NUM];            /* 实测轮速 (RPM，已方向归一) */
    float wheel_duty[CHASSIS_WHEEL_NUM];                /* 各轮输出占空比（千分比） */
    int32_t wheel_count[CHASSIS_WHEEL_NUM];             /* 各轮编码器累计计数（原始方向） */

    /* ---- 里程计（相对上电位姿） ---- */
    float x, y;     /* m */
    float yaw;      /* rad，逆时针为正 */

    uint8_t driver_on;  /* 1 = TB6612 STBY 高（输出使能），0 = 输出高阻自由 */

    /* ---- IMU / 陀螺外环 ---- */
    float imu_wz;       /* 陀螺实测 wz (rad/s，已去零偏、低通) */
    float imu_yaw;      /* 陀螺积分偏航角 (rad，-PI..PI) */
    float wz_eff;       /* 陀螺外环输出、实际用于运动学逆解的 wz (rad/s) */
    uint8_t imu_online; /* 1 = IMU 在线且配置成功 */
} chassis_state_t;

/** 初始化：绑定电机/编码器、启动 PWM 与编码器、置高 STBY */
void chassis_init(void);

/**
 * @brief 主循环高频调用；内部检测 1kHz tick，到点执行一次控制循环。
 *        调用得越勤，节拍越准；未到 tick 时立即返回。
 */
void chassis_poll(void);

/** 设定车体目标速度，自动限幅 */
void chassis_set_velocity(float vx, float vy, float wz);

/** 停止（目标速度清零，经斜坡减速） */
void chassis_stop(void);

/** chassis_stop() 被调用的累计次数（诊断用：看门狗/EN=0/急停清速度的痕迹） */
uint32_t chassis_stop_count(void);

/** 里程计清零：x/y/yaw 归零（不动电机、不清 PID；上位机「重新定原点」用） */
void chassis_reset_odometry(void);

/** 读取底盘状态（测量值/里程计，只读） */
const chassis_state_t *chassis_state(void);

/** 底盘库时钟 (ms)，基于 HAL_GetTick，1kHz */
uint32_t chassis_tick_ms(void);

/* ============================ IMU / 小陀螺 =================================
 * 更细的控制（云台跟随角度环、模式切换、自旋速率）在 chassis_gyro.h 里。
 */
/** 小陀螺：以指定角速度原地自旋 (rad/s，逆时针为正)。传 0 退出自旋回到角速度闭环 */
void chassis_spin(float rad_s);

/** IMU 是否在线（1 = 陀螺外环可用） */
uint8_t chassis_imu_online(void);

/* ========================= 调试/整定专用入口 ===============================
 * 正常跑车只用上面的接口；下面这些是给 chassis_tune 调 PID 用的，
 * 会绕过运动学与斜坡，直接给四轮下指令。正式固件里保持 CHASSIS_MODE_NORMAL 即可。
 */
typedef enum
{
    CHASSIS_MODE_NORMAL = 0,    /* 车体速度指令 -> 运动学逆解 -> 斜坡 -> 速度环 */
    CHASSIS_MODE_OPEN_DUTY,     /* 四轮直接给同一占空比，绕过 PID（开环标定用） */
    CHASSIS_MODE_WHEEL_REF,     /* 四轮直接给轮速目标，无斜坡（阶跃响应用） */
} chassis_mode_t;

/** 切换工作模式（切换时会清 PID 积分，避免残留） */
void chassis_set_mode(chassis_mode_t mode);

/** 模式 2：四轮同占空比 [-1000, +1000]，立即生效 */
void chassis_set_open_duty(float duty);

/** 模式 3：四轮各自的目标轮速 (RPM)，正=向前滚 */
void chassis_set_wheel_ref(const float rpm[CHASSIS_WHEEL_NUM]);

/** 整定/自检用：0 = 把 TB6612 STBY 拉低（输出高阻、电机自由滑行），1 = 正常使能 */
void chassis_driver_enable(int on);

/** 整定用：在线改某一轮的 PI 增益与加速度前馈（会清积分），kff 不动 */
void chassis_set_wheel_gain(int idx, float kp, float ki, float kacc);

#endif /* USERLIB_CHASSIS_CHASSIS_H */
