326hhh/HLJU_RMIC_chassis/(commit log)

2026-10-03 feat: 加入 STM32F407 麦轮底盘控制代码
    - UserLib/Chassis: 四路编码器测速 + TB6612 驱动 + 麦轮运动学 + PID 闭环
    - docs/CHASSIS_LIBRARY.md: 底盘库接口说明
    - README: 接线表、编译与烧录说明
    - .gitignore: 忽略 build/ 与编译用不到的 CMSIS 目录
    [20251003_pid_v05_6min.csv]
2026-10-06 chore: VOFA 实测 CSV 不入库
    - .gitignore 增加 test_data/*.csv，7 个 VOFA+ 导出数据只留本地
    - git rm --cached 20251003_pid_v05_6min.csv（历史中那份保留，未改写）
    - 补充 test_data/说明.md：v0.6 前馈效果、BR 编码器接触不良排查结论
    [20251003_pid_v05_6min.csv]
2026-10-06 引脚修改
2026-10-08 docs: 仓库纳入扩展板硬件资料
    - 新增 hardware/：扩展板原理图 PDF（5 页）+ 嘉立创EDA 工程文件
    - .gitignore 增加 EDA 自动备份目录 *_backup/ 与系统垃圾文件忽略规则
    - docs/CHASSIS_LIBRARY.md §15 版本记录 0.8：登记仓库资料变更（本库代码无改动）
2026-10-08 新增扩展板和引脚
2026-10-18 chore: test_data/tune_runs 调参日志不入库
2026-10-18 调好了速度环
2026-10-18 加入IMU辅助底盘控制
2026-10-19 实现了底盘通过串口和Jetson交互
2026-11-02 Jeston和底盘单片机的通信
2026-11-02 实现了小车的原地转向，修改了小车原地转向的会卡顿的问题，和AD移动方向相反的问题
2026-11-04 docs: 三份文档合并为 docs/README.md，并同步全部引用
    - 新增 docs/README.md（1663 行）：原 CHASSIS_LIBRARY.md / CAN_TEST.md /
    CAN_CONTROL_PROTOCOL.md 合并精简，章节号沿用 1~19，代码里的 §x 引用保持有效
    - 删除上述三份原文档（内容已并入）
    - 同步 12 个文件的引用与章节号：根 README、hardware/README、test_data/README、
    UserLib/Chassis/{README.md,chassis.c,chassis_config.h,mecanum.c}、
    UserLib/Comm/{README.md,can_link.c,can_link_config.h}、UserLib/IMU/README.md
    - 顺带修正根 README 里未闭合的括号、以及 hardware/README 的原理图文件更名
2026-11-04 hardware: 换成 2026-11-05 版扩展板原理图与立创 EDA 工程
    - 新增 SCH_Schematic1_2026-11-05.pdf（656K）、校内赛底盘扩展板.epro2（1.7M）
    - 删除旧版 底盘扩展板原理图_2026-10-09.pdf、
    校内赛底盘扩展板_2026-10-06_14-20-59_2026-10-09.epro2
    - H5(IMU) 座 SDA/SCL 交叉已在新版原理图修正，SA0 接地
